Lianglanquan/--2026/机械资料/03_适配模型/04_装配检查/全适配总装_v1_轴测预览.png

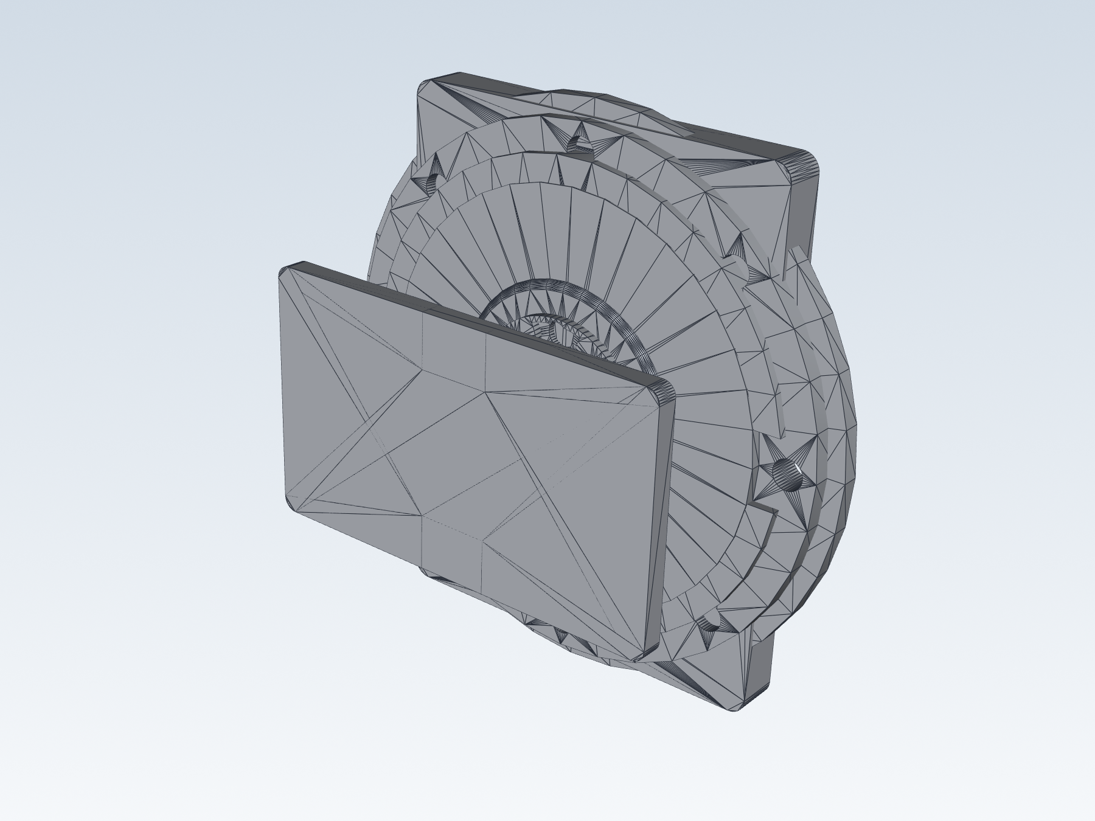
机械资料/03_适配模型/04_装配检查/全适配总装_v1_轴测预览.png
