Lianglanquan/--2026/docs/superpowers/specs/2026-09-16-ha8-qd4310-mechanical-adapter-design.md

# 灯哥轮足机器人 HA8 与 QD4310 机械适配设计

日期：2026-09-16

## 1. 目标

在灯哥 StackForce 小型双足轮足机器人公开机械模型基础上，完成一套可制造、可拆装的接口适配模型，使机器人采用：

- 腿部关节：FashionStar `HA8-U25H-M` 总线舵机 ×4；
- 左右轮驱动：`QD4310` 外转子无刷电机 ×2；
- QD4310 直驱车轮，不增加齿轮、同步带或额外传动级。

设计尽量保持原机器人的腿长、关节中心、轮轴中心、车轮外径、轮宽和总体外观比例。原始 STL 只作为几何参考，绝不覆盖、改写或替换。

## 2. 已确认的设计原则

- 保留原版车轮约 `Ø66 × 30 mm` 的外包络及原轮胎。
- HA8 输出侧使用官方金属 25T 主舵盘；不打印、不重建 25T 花键。
- HA8 背面中心 M3 螺纹孔作为被动支撑轴的连接点，形成双侧支撑。
- QD4310 定子固定在腿部末端，外转子与车轮轮毂连接。
- 优先新增或局部替换接口件，不为了统一外观重做不受影响的结构件。
- 所有原始 CAD、STEP、STP、STL、DWG 和 PDF 保持原样并留在现有资料目录。

## 3. 输入资料与设计基准

### 3.1 原始结构

原始 STL 位于：

`机械资料/01_灯哥小型轮足/01_原版STL/`

现有公开模型共 29 个 STL。设计基准包括原腿长、关节中心、轮轴中心、原车轮外轮廓和原结构件之间的搭接关系。

### 3.2 HA8-U25H-M

官方资料位于：

`机械资料/02_华馨京_HA8-U25H-M/`

设计使用以下已核对特征：

- 舵机本体约 `40 × 20 × 40 mm`；
- 安装耳总高约 `56 mm`；
- 安装孔为 `4 × Ø4.3 mm`；
- 输出轴为约 `Ø5.9 mm / 25T`；
- 背面中心连接为 `M3`；
- 输出侧使用官方 `main-horn-25T-8holes-3D.STEP` 金属舵盘模型作为装配基准。

具体孔距、安装耳位置、输出轴偏置和舵盘孔位以官方 STEP/DWG 为唯一建模依据，不从网页示意图反推。

### 3.3 QD4310

设计使用本地 `QD4310使用手册.pdf` 中的尺寸页作为基准：

- 电机外径 `Ø49 mm`；
- 总厚度 `26.7 mm`；
- 主体厚度标注 `15 mm`；
- 转子侧连接为 `8 × M3 × 0.5`；
- 定子后侧连接为 `4 × M2.5 × 0.45`，孔系 `Ø38.5 mm`。

手册未明确或图纸无法唯一判定的尺寸不得猜测。相关位置保留为可调参数，并在首件装配前用实物复测。

## 4. 修改范围

### 4.1 首版必须输出的适配件

HA8 关节接口：

- `舵机接口1~4` 的 HA8 适配版本；
- 与 HA8 本体和背面被动轴发生干涉的 `外固定1~4` 适配版本；
- 与 HA8 外形、线束或螺钉工具空间发生干涉的 `盖板1~4` 适配版本。

QD4310 轮端接口：

- `电机固定X1/X2` 的 QD4310 定子安装版本；
- `轮固定X1/X2` 的 QD4310 直驱适配版本；
- `轮毂X1/X2` 的 QD4310 外转子连接版本。

左右件应由同一套参数化几何镜像生成，不分别手工绘制两套尺寸。

### 4.2 原则上保持不变的零件

- `大腿1~4`；
- `前小臂X1/X2`；
- `后小臂X1/X2`；
- `框架.stl`；
- `上盖.stl`；
- `电池架.stl`；
- 原轮胎和车轮外轮廓。

只有在装配检查证明存在不可消除的实体干涉、紧固件无法安装或线束无法通过时，才允许将受影响零件加入后续修改范围。不得为了凑齐新模型而重建这些零件。

## 5. HA8 关节结构

### 5.1 输出侧

官方金属 25T 主舵盘安装在 HA8 输出轴上。新增打印适配盘通过官方舵盘的机械孔连接原腿部件，承担扭矩传递。打印件不直接拟合花键，也不依靠摩擦夹紧输出轴。

适配盘必须：

- 保持原关节旋转中心位置；
- 为舵盘中心紧固螺钉和周向螺钉提供装配及工具空间；
- 使用沉孔、柱形沉台或螺母槽时保证周围最小壁厚；
- 使舵盘金属面可靠贴合，不让打印毛边成为主要定位面。

### 5.2 被动支撑侧

HA8 背面中心 M3 连接被动支撑轴。被动轴与外侧支撑件配合，使关节形成双侧支撑，但不得把轴向预紧力直接施加到舵机壳体导致卡滞。

被动侧采用可拆换轴套/隔套结构，并满足：

- 与输出轴同轴；
- 允许通过垫片调整轴向间隙；
- 不把普通打印孔作为高负载旋转轴承面；
- 优先容纳金属隔套、法兰轴承或耐磨衬套，最终规格由实物空间复核后确定。

### 5.3 舵机本体固定与线束

HA8 使用安装耳固定，本体不采用破坏外壳的夹持方式。设计需留出：

- 四个安装孔的螺钉、垫片和螺母空间；
- UART/电源线的自然弯曲半径；
- 插头拔插和舵机独立拆卸路径；
- 至少一个明确的线束出口与防磨边缘。

舵机零位应在参数化装配中显式定义，四个关节使用一致的零位基准和镜像方向说明。

## 6. QD4310 轮端结构

### 6.1 定子固定

电机后侧 `4 × M2.5` 孔固定到腿部末端支架。支架承担定子反扭矩，并保持原轮轴中心。支架必须为电机线束留出不被转子扫过的出口。

### 6.2 转子与轮毂

车轮轮毂通过转子侧 `8 × M3` 孔连接 QD4310 外转子。连接面以电机官方端面和孔系定位，禁止依赖打印件内孔与转子外圆的过盈夹紧承担主要扭矩。

轮毂设计必须：

- 保持约 `Ø66 mm` 原车轮外径与约 `30 mm` 总宽度；
- 使轮胎中心平面尽量与原轮胎中心平面重合；
- 留出 M3 螺钉头、工具和拆装空间；
- 避免固定螺钉突出到轮胎、地面或静止支架的扫掠区；
- 提供可靠的径向定位台阶，螺钉主要承担夹紧和扭矩传递。

### 6.3 轴向空间

QD4310 总厚度 `26.7 mm`，接近原轮约 `29.9 mm` 宽度。首版模型必须通过剖面检查证明电机、支架、轮毂、螺钉和轮胎全部位于允许包络内。若无法同时满足，应优先小幅调整轮毂内腔和支架厚度，不改变原车轮外径；任何轮宽增加都必须单独标注并再次确认。

## 7. 参数化建模与文件组织

新增目录：

```text
机械资料/03_适配模型/
├── 01_参数化源文件/
├── 02_STEP装配与零件/
├── 03_STL打印件/
├── 04_装配检查/
└── 05_设计说明/
```

要求：

- 参数化源文件是适配模型的主数据；
- 每个制造零件同时导出 STEP 和 STL；
- STEP 使用毫米单位，保留实体；
- STL 使用毫米单位，保持封闭、流形和正确法向；
- 文件名包含用途、侧别和版本，不覆盖原始文件；
- 输出目录中附带输入资料、关键尺寸、版本和导出记录；
- 原始 STL 不经布尔运算后覆盖回原目录。

若当前环境选用 CadQuery，则源文件使用可复现的 Python/CadQuery 参数化脚本；若选用 FreeCAD，则保留原生参数化工程。不得只交付无法追溯参数的 STL。

## 8. 制造尺寸规则

首版按常见 FDM 打印和金属紧固件装配设计，采用以下默认规则：

- 普通穿孔相对公称螺钉直径增加 `0.2~0.4 mm`；
- 打印件活动配合单边间隙初值 `0.20 mm`；
- 非活动插接定位单边间隙初值 `0.10~0.15 mm`；
- 承力外壁和螺钉柱有效壁厚原则上不小于 `3.0 mm`；
- 热熔铜螺母、压入螺母和轴承配合不使用通用经验值直接定稿，必须按实际采购件尺寸建模；
- M2.5 与 M3 螺纹由金属件承担；打印件默认使用穿孔、螺母或铜螺母，不直接打印承力细牙螺纹。

所有默认间隙均作为参数保存。首件打印后可按实际打印机、材料和安装件实测统一调整。

## 9. 装配与验证

### 9.1 数字检查

- 原关节中心和轮轴中心相对基准的偏差不超过 `0.20 mm`；
- 左右镜像件的非镜像尺寸完全一致；
- HA8 全关节预期转角内无本体、安装耳、线束和腿部件碰撞；
- QD4310 转子、轮毂和轮胎扫掠体不碰静止支架或线束；
- 所有螺钉均存在可执行的装入方向与工具空间；
- 每个电机和舵机可单独拆卸，不需要破坏打印件；
- 所有 STL 均为非空、封闭流形，并记录三角面数量和包围盒；
- STEP 与 STL 的包围盒一致，单位无 25.4 倍或 1000 倍错误。

### 9.2 实物首件检查

在最终承力打印前，先制作低成本接口样件验证：

- HA8 安装耳孔位、输出侧舵盘孔位和背面 M3 同轴性；
- QD4310 前后孔系、端面位置和线束出口；
- 原轮胎与新轮毂配合；
- 关节零位、可用转角和拆装顺序。

实测偏差写回参数，不直接在 STL 网格上修补。

## 10. 输出清单

首版至少交付：

- HA8 输出侧适配盘 `1~4` 四个编号变体，由同一套参数和镜像规则生成；
- HA8 被动支撑件及所需隔套；
- HA8 本体安装/外固定适配件；
- 受干涉影响的盖板适配件；
- QD4310 左右定子支架；
- QD4310 左右直驱轮毂/轮固定结构；
- 参数化源文件；
- 对应 STEP、STL；
- 总装或分总成 STEP；
- 爆炸图、剖面图或装配截图；
- 零件与紧固件 BOM；
- 尺寸来源、假设、实物待复测项和版本记录。

## 11. 明确不在本轮范围内

- 修改电控、固件、总线协议或控制算法；
- 改变腿长、关节中心、轮轴中心或运动学参数；
- 重新设计整机外壳、框架、电池架或腿部主体；
- 为 HA8 打印 25T 花键；
- 为 QD4310 增加减速器或传动机构；
- 修改或覆盖任何官方/开源原始模型；
- 在未取得实物尺寸时猜测未标注的配合尺寸。

## 12. 完成标准

本轮机械适配完成需同时满足：

1. 四个 HA8 关节保持原旋转中心并具备输出侧金属舵盘连接和背面被动支撑；
2. 两个 QD4310 以定子固定、外转子驱动车轮的方式安装，并保持原轮外径；
3. 原始 STL 全部未被修改；
4. 每个新增制造件都有参数化源、STEP 和 STL；
5. 数字装配检查无实体干涉，紧固件和线束具有可执行的安装路径；
6. 所有无法由官方图纸确认的配合尺寸均被标为实物待复测项，而不是被静默猜测；
7. 输出清单、BOM、校验结果和版本说明完整。
