Lianglanquan/--2026/docs/HA8_遥想星空腿杆接口资料汇总_v1.md

# HA8 总线舵机与遥想星空腿杆接口资料汇总
+
版本：v1
日期：2026-09-24
状态：结构方案评审资料，不是最终加工图
+
## 1. 当前要解决的问题
+
遥想星空 `Skythinker616/foc-wheel-legged-robot` 原结构的关节模块使用 4010 电机。当前目标是用华馨京 / FashionStar `HA8-U25H-M` 总线舵机替换原 4010 关节，并让 HA8 的原厂金属 25T 舵盘与遥想星空腿杆可靠连接。
+
本阶段只处理 HA8 关节接口，不确定 QD4310 轮端执行器，不修改车身、电池架、上盖和轮胎。
+
## 2. 资料来源
+
### 2.1 遥想星空开源项目
+
- GitHub：`https://github.com/Skythinker616/foc-wheel-legged-robot`
- Gitee 入口：项目 README 中的 `skythinker/foc-wheel-legged-robot` 链接
- MATLAB 腿部解算：`matlab/leg_func_calc.m`
- MATLAB 生成函数：`matlab/leg_pos.m`、`matlab/leg_conv.m`
- 平衡控制腿长范围：`matlab/sys_calc.m`
- 机械源文件：`solidworks/大腿.SLDPRT`、`solidworks/小腿.SLDPRT`、`solidworks/关节电机支架.SLDPRT`、`solidworks/总装.SLDASM`
- 本地 STEP 交付包：`/home/fool/Documents/xwechat_files/wxid_4mpuku9s8v2522_6753/msg/file/2026-09/FOC双轮腿机器人_STEP.zip`
- 本地 STEP 目录：`机械资料/05_FreeCAD设计/` 和 `/data/extra/codex-tmp/focstep/`
- URDF/CSV：`机械资料/01_灯哥小型轮足/03_来源说明/SF_bipedalWheel.zip` 中的 `urdf/20250820_1.urdf` 与 `urdf/20250820_1.csv`
+
### 2.2 HA8 官方资料
+
- 舵机型号：`HA8-U25H-M`
- 官方手册：`机械资料/02_华馨京_HA8-U25H-M/02_尺寸图_DWG_PDF/Fashion-Star-HA8-U25H-M.pdf`
- 官方系列尺寸图：`机械资料/02_华馨京_HA8-U25H-M/02_尺寸图_DWG_PDF/ha8-hp8-hx8-series-dimension.pdf`
- 官方本体 STEP：`机械资料/02_华馨京_HA8-U25H-M/01_舵机本体_STEP/ha8-hp8-hx8-series-3D.STEP`
- 官方金属舵盘 STEP：`机械资料/02_华馨京_HA8-U25H-M/03_25T舵盘/main-horn-25T-8holes-3D.STEP`
- 官方金属舵盘尺寸图：`机械资料/02_华馨京_HA8-U25H-M/03_25T舵盘/25T主舵盘外观尺寸图.pdf`
+
### 2.3 项目中已有的参数化参考
+
- HA8 适配源文件：`机械资料/03_适配模型/01_参数化源文件/wheelbot_adapter/`
- HA8 现有输出接口源：`ha8_adapters.py`
- HA8 参数源：`parameters.py`
- 现有 HA8 STEP 输出：`机械资料/03_适配模型/02_STEP装配与零件/HA8_舵机接口1~4_v1.step`
- 现有 HA8 STL 输出：`机械资料/03_适配模型/03_STL打印件/HA8_舵机接口1~4_v1.stl`
- 现有设计说明：`机械资料/03_适配模型/05_设计说明/README_适���模型.md`
- 实物待复测清单：`机械资料/03_适配模型/05_设计说明/实物待复测项.md`
+
现有参数化适配件主要是数字装配参考，不能直接宣称已经和遥想星空腿杆最终孔位完成实体装配验证。
+
## 3. 已锁定的 HA8 数据
+
以下数值有官方手册、官方 STEP 或项目参数化源文件依据，可以作为 FreeCAD 建模基线：
+
| 项目 | 数值 | 数据来源 |
-|-|-|
| 舵机型号 | HA8-U25H-M | 官方手册 |
| 本体包络 | 40 × 20 × 40 mm | 官方手册 / 官方 STEP |
| 安装耳总高 | 56 mm | 官方尺寸图 |
| 安装孔数量和名义孔径 | 4 × Ø4.3 mm | 官方尺寸图 / 官方 STEP 圆柱孔 |
| 输出形式 | Ø5.9 mm / 25T | 官方手册和尺寸图 |
| 背面中心连接 | M3 | 官方尺寸图 |
| 官方金属主舵盘 | 25T、八孔 | 官方舵盘 STEP / 尺寸图 |
| 舵盘周向孔 | 8 × Ø1.8 mm | 官方舵盘 STEP 解析 |
| 舵盘孔节圆 | BCD Ø16 mm | 官方舵盘 STEP 解析 |
| 打印承力外壁初值 | 不小于 3.0 mm | 项目打印规则 |
| 活动配合初值 | 单边 0.20 mm | 项目打印规则 |
| 定位配合初值 | 单边 0.10–0.15 mm | 项目打印规则 |
+
注意：官方舵盘的 25T 花键属于金属采购件。打印件不打印、不重建、也不承担 25T 花键功能。
+
## 4. 遥想星空腿部数据
+
### 4.1 MATLAB 杆长参数
+
`matlab/leg_func_calc.m` 中的腿部杆长为：
+
```matlab
l1 = 0.05;   % 50 mm
l2 = 0.105;  % 105 mm
l3 = l2;     % 105 mm
l4 = l1;     % 50 mm
l5 = 0.06;   % 60 mm
```
+
对应关系：
+
- `l1 = l4 = 50 mm`：两侧短连杆 / 电机侧几何杆长；
- `l2 = l3 = 105 mm`：两根长腿杆几何杆长；
- `l5 = 60 mm`：基座两侧连接点的几何间距参数；
- `L0` 虚拟腿长控制拟合范围：`40–140 mm`；
- `L0 = 70 mm` 是常用标称腿长参考值。
+
这些是运动学模型参数，不等于每个打印件的外轮廓尺寸。腿杆端部法兰需要继续从原始 SolidWorks / STEP 总装测量。
+
### 4.2 URDF 关节基准
+
本地 URDF/CSV 给出的关节轴主要沿 Y 轴。轮轴相对小腿关节的局部平移约为 100 mm，当前记录值约 `99.98 mm`。该值是 URDF 原点链推导的参考，整机绝对装配位置仍需总装 STEP 复核。
+
## 5. 本次确定的 HA8 到腿杆连接方案
+
### 5.1 两套接口必须分开
+
1. **HA8 本体固定接口**
   - HA8 两侧安装耳插入或贴合 3D 打印外固定支架。
   - 外固定支架通过 `4 × Ø4.3 mm` 安装耳孔用螺钉固定 HA8 本体。
   - 这套接口只负责把舵机壳体固定到腿部/车身支撑结构，不能承担腿杆输出连接。
+
2. **HA8 输出接口**
   - HA8 顶部安装原厂金属 25T 八孔主舵盘。
   - 遥想星空腿杆关节端不再沿用原 4010 电机输出端，而是重新设计为带法兰的腿杆端部。
   - 腿杆法兰的八个通孔按官方金属舵盘的八孔位置布置，与舵盘同轴。
   - 螺钉穿过金属舵盘周向孔，把金属舵盘和腿杆端部法兰锁紧。
   - 扭矩传递路径为：HA8 25T 花键 → 金属舵盘 → 周向螺钉/法兰贴合面 → 遥想星空腿杆。
   - 腿杆不能直接锁在 HA8 塑料/铝合金壳体上，不能把一个普通圆柱体当成输出接口。
+
### 5.2 腿杆端部法兰应该画成什么
+
工程图应至少包含：
+
- 遥想星空大腿或小腿杆本体的关节端截面；
- 与官方金属舵盘贴合的法兰面；
- 八个与舵盘同轴的通孔；
- 中央输出轴 / 中心螺钉工具避让孔；
- 法兰外缘的承力壁和圆角；
- 螺钉头或螺母的装配方向；
- HA8 输出轴中心、腿杆关节中心和法兰中心的同轴关系；
- 侧视剖面，明确金属舵盘、法兰、腿杆本体的层叠关系。
+
本阶段不应画出未经确认的螺钉长度、螺纹有效深度、腿杆最终孔距或盲孔深度。它们应在图中标为“��实测 / 待与总装 STEP 复核”。
+
### 5.3 背面被动支撑
+
- HA8 背面中心 M3 只用于连接被动支撑轴或支撑座。
- 被动侧应使用金属隔套、法兰轴承或耐磨衬套。
- 普通打印孔不能直接作为高负载旋转轴承面。
- 需要留出垫片或隔套调整轴向间隙，不能用 HA8 壳体承受轴向预紧。
+
## 6. 仍然不能直接锁死的尺寸
+
这些项目必须用官方 STEP、原始总装或实物确认，不能从网页示意图猜测：
+
- HA8 两侧安装耳孔的精确中心距和相对输出轴偏置；
- HA8 输出轴中心到安装基准面的精确距离；
- 官方金属舵盘的实际螺钉规格、有效螺纹深度和装配工具空间；
- 遥想星空原始腿杆关节端最终孔位、端面厚度和法兰外轮廓；
- 输出转接法兰的孔径补偿和沉孔/螺母槽形式；
- 背面被动支撑轴、轴承或衬套型号、外径、长度和轴向间隙；
- HA8 线束出口方向、插头尺寸和最小弯曲半径；
- 原始整机绝对装配坐标和四个关节与车身的最终安装关系。
+
## 7. 本阶段 FreeCAD 建模顺序
+
1. 导入官方 HA8 本体 STEP。
2. 导入官方 25T 八孔金属舵盘 STEP。
3. 导入遥想星空原始大腿 / 小腿端部 STEP 或根据总装截面建立腿杆端面参考。
4. 以 HA8 输出轴为关节基准轴，将金属舵盘与腿杆端部法兰同轴叠合。
5. 在腿杆端部建立八孔通孔和中央工具避让孔。
6. 再建立 HA8 两侧耳外固定支架和背面被动支撑。
7. 先检查螺钉装入方向、法兰贴合、线束空间和关节扫掠，再复制到镜像腿。
8. 通过 FreeCAD 截面和干涉检查后，才导出 STEP/STL。
+
## 8. 当前已有图纸与生成图
+
- 遥想星空原始腿部参数基线：`机械资料/05_参数图/遥想星空原始腿部参数基线_v1.png`
- 第一版 HA8 接口概念图：`机械资料/05_参数图/HA8总线舵机关节接口设计图_v1.png`
- 本次修正版目标图：`机械资料/05_参数图/HA8腿杆端部法兰与金属舵盘接口工程图_v2.png`
+
第一版图的问题是只表达了 HA8 模块关系，没有把腿杆端部按官方金属舵盘孔系重新设计并画出。修正版应以厂家机械图样式表达腿杆法兰和舵盘锁紧关系。
+
## 9. 结论
+
这次的设计重点不是再增加一个孤立转接盘，而是修改遥想星空腿杆关节端：让腿杆端部本身带有与官方金属舵盘相匹配的法兰和八孔接口。HA8 本体由侧耳支架固定，腿杆通过金属舵盘与端部法兰传递扭矩，背面再用 M3 被动支撑保持同轴。
+
在腿杆最终孔位、HA8 精确基准距离、螺钉规格和被动支撑件确认前，这份资料和生成图只能作为 FreeCAD 结构评审基线，不能直接作为最终加工图或直接打印承力件。
