Lianglanquan/--2026/firmware/esp32_s3/UPSTREAM.md

# Upstream provenance

- Project: https://github.com/78/xiaozhi-esp32
- Commit: `5d54beb743ff49c4e8db81bbef9413bdd6e2ba17`
- Imported: 2026-09-16
- License: MIT; see `LICENSE`
- Local additions: `wheelbot-s3-audio` board and `local_components/wheelbot_control`
