Lianglanquan/--2026/docs/superpowers/plans/2026-09-13-机械原始资料下载.md

# 轮足机器人机械原始资料下载实施计划

> **For agentic workers:** REQUIRED SUB-SKILL: Use superpowers:subagent-driven-development (recommended) or superpowers:executing-plans to implement this plan task-by-task. Steps use checkbox (`- [ ]`) syntax for tracking.

**Goal:** 从公开官方/开源来源下载 StackForce 灯哥小型轮足机器人和 FashionStar HA8-U25H-M 相关机械资料，按中文目录保存原始文件，生成来源说明、校验结果和最终 ZIP。

**Architecture:** 先以 Git 仓库和官方直链为主获取原始文件，所有来源先进入临时下载区并记录 URL、版本/提交和 SHA256，再复制到最终中文目录。对 FashionStar 资料按“明确 HA8-U25H-M”“同尺寸系列参考”“未找到”三类归档，禁止转换、重建、覆盖同名文件。

**Tech Stack:** `git`, `curl`/`wget`, `unzip`, `find`, `sha256sum`, `zip`, Markdown。

**Spec:** 用户在当前对话中提供的“轮足机器人机械公开资料下载、整理、校验和打包”要求。

## Global Constraints

- 只使用公开官方或开源资源。
- 不生成、转换、重建或修改任何 STL、STEP、STP、DWG、PDF、URDF、mesh、配置文件。
- 保留原始文件名和原始内容；同名文件不静默覆盖。
- StackForce 原始 STL 与 Seeed 官方 URDF/STL 包分开保存。
- HA8-U25H-M 必须与 HA8-U25-M 7.4V 区分。
- QD4310、HA8 适配属于后续工作，本次不修改任何 CAD。
- 下载日期统一记录为 2026-09-13（Asia/Shanghai）。

---

### Task 1: 核对并获取 StackForce 官方资源

**Files:**
- Create: `机械资料/临时下载/StackForce-GitHub/`
- Create: `机械资料/临时下载/StackForce-Gitee/`
- Create: `机械资料/临时下载/SF_bipedalWheel.zip`

- [ ] 克隆 GitHub 仓库并记录提交哈希。
- [ ] 检查 Gitee 官方镜像并在 GitHub 失败或内容不一致时比较模型目录。
- [ ] 下载 Seeed 官方 ZIP，记录 HTTP URL、文件大小和 SHA256。
- [ ] 枚举仓库模型目录全部 STL，核对用户列出的打印件清单。

### Task 2: 整理 StackForce 目录

**Files:**
- Create: `机械资料/01_灯哥小型轮足/01_原版STL/`
- Create: `机械资料/01_灯哥小型轮足/02_Seeed官方URDF_STL/`
- Create: `机械资料/01_灯哥小型轮足/03_来源说明/`

- [ ] 原样复制仓库模型目录内全部 STL 到 `01_原版STL/`。
- [ ] 原样解压 Seeed ZIP 全部 URDF、STL、mesh、配置文件到 `02_Seeed官方URDF_STL/`。
- [ ] 对同名文件执行显式冲突检查，不覆盖已有文件。
- [ ] 写入 StackForce 来源说明和文件清单。

### Task 3: 核对并获取 FashionStar HA8 资料

**Files:**
- Create: `机械资料/临时下载/servo-dimension/`
- Create: `机械资料/临时下载/FashionStar官方页面快照/`

- [ ] 获取产品页、官方技术文档/CAD 页面和 `servodevelop/servo-dimension` 的公开文件列表。
- [ ] 只将产品型号明确为 `HA8-U25H-M` 的文件归入确定资料。
- [ ] 将可证明为 40×20×40 mm、单轴、25T 但无法证明具体为 HA8-U25H-M 的原始文件归入“同尺寸系列参考”。
- [ ] 未找到的 STEP/STP、DWG、PDF、舵盘或支架明确记录“官方公开资源中未找到”。

### Task 4: 整理 FashionStar 目录和总 README

**Files:**
- Create: `机械资料/02_华馨京_HA8-U25H-M/01_舵机本体_STEP/`
- Create: `机械资料/02_华馨京_HA8-U25H-M/02_尺寸图_DWG_PDF/`
- Create: `机械资料/02_华馨京_HA8-U25H-M/03_25T舵盘/`
- Create: `机械资料/02_华馨京_HA8-U25H-M/04_舵机支架/`
- Create: `机械资料/02_华馨京_HA8-U25H-M/05_来源说明/`
- Create: `机械资料/README_机械资料说明.md`

- [ ] 保留原始文件名并按确定性归档，不改写 CAD 文件。
- [ ] README 记录来源 URL、Git 地址、下载日期、格式、官方性、HA8 确定性、同尺寸参考和后续适配清单。
- [ ] 记录灯哥原始结构与 HA8 官方模型的边界。

### Task 5: 全量校验和打包

**Files:**
- Create: `轮足机器人_机械原始资料_灯哥+HA8.zip`
- Create: `机械资料/05_校验/文件清单.tsv`
- Create: `机械资料/05_校验/SHA256SUMS.txt`

- [ ] 输出完整文件树。
- [ ] 统计 STL、STEP/STP、DWG、PDF、URDF 数量。
- [ ] 检查空文件和 ZIP 解压完整性。
- [ ] 对重要文件计算 SHA256。
- [ ] 检查 ZIP 内部全部使用中文目录。
- [ ] 重新读取校验结果后再报告完成状态和缺失项。
