Lianglanquan/--2026/机械资料/03_适配模型/05_设计说明/实物待复测项.md

# 实物待复测项

当前状态：数字装配版 v1。以下项目未完成前，不得将模型表述为已实体装车验证或直接用于最终承力打印。

## HA8-U25H-M

1. 安装耳实际厚度、四个 Ø4.3 孔的孔径公差和中心距。用游标卡尺及针规测量，并与官方 STEP 叠合检查。
2. 官方金属 25T 八孔主舵盘的实际孔径、孔距、厚度和中心螺钉工具空间。
3. 背面 M3 孔的有效螺纹深度、端面到壳体的轴向距离和允许预紧力。
4. 被动侧金属隔套、法兰轴承或耐磨衬套的采购型号、外径、长度和配合公差。当前 `passive_insert_outer_diameter_mm` 与 `passive_insert_length_mm` 保持未解析。
5. UART/电源插头尺寸、出线位置和最小自然弯曲半径。

## QD4310

1. 转子侧 8×M3 孔的节圆直径（BCD）、角度起点、有效螺纹深度和端面定位尺寸。官方公开手册没有唯一给出 BCD，这是当前最关键的未解析项。
2. 定子侧 4×M2.5、Ø38.5 BCD 的实物孔位和螺纹深度。
3. 前后端面位置、转子与定子的实际分界半径、外转子扫掠包络。
4. 三相线束实际出线位置、插头尺寸和与静止支架的距离。

## 原车轮与打印工艺

1. 原轮胎内孔、卡槽、压缩量和中心平面；核对新轮毂与约 Ø66×29.9 mm 外包络。
2. 打印机在目标材料和层高下的 M2.5/M3 孔径补偿、定位台阶补偿和轴承/隔套压入量。
3. 从完整原装配或实物测量四个关节和两个轮轴的绝对装配坐标。孤立 STL 只能保留局部中心，不能唯一恢复整机绝对位置。

复测后只修改 `01_参数化源文件/wheelbot_adapter/parameters.py` 或对应的命名待测参数，再运行 `build_all.py`；不要直接修补导出的 STL。
