Lianglanquan/--2026/tmp/pdfs/HA8_系列尺寸-1.png

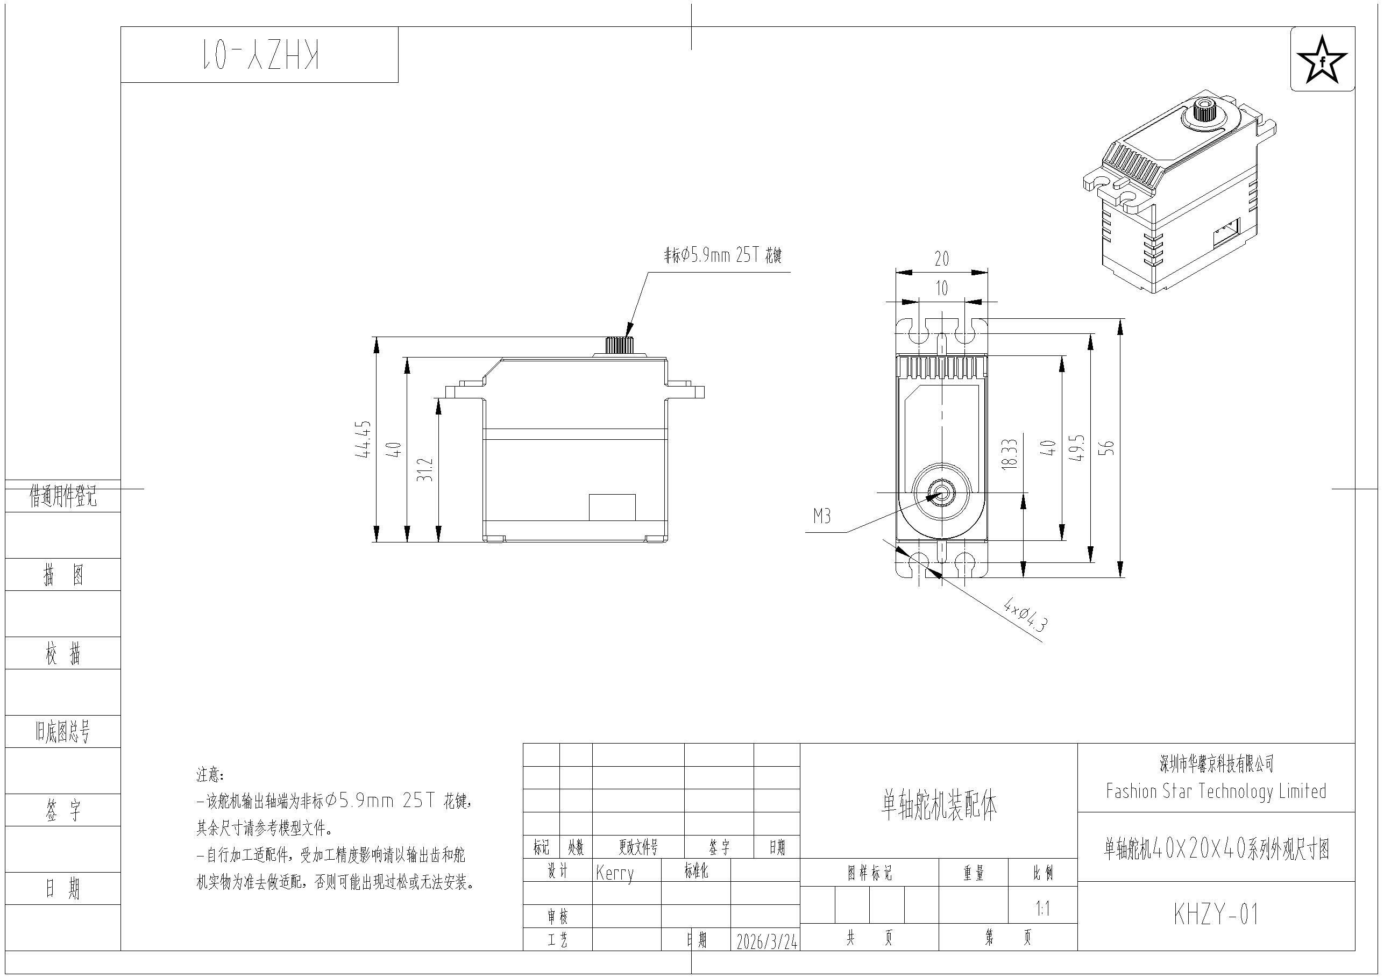
tmp/pdfs/HA8_系列尺寸-1.png
