Lianglanquan/--2026/tmp/pdfs/QD4310_产品尺寸-06.png

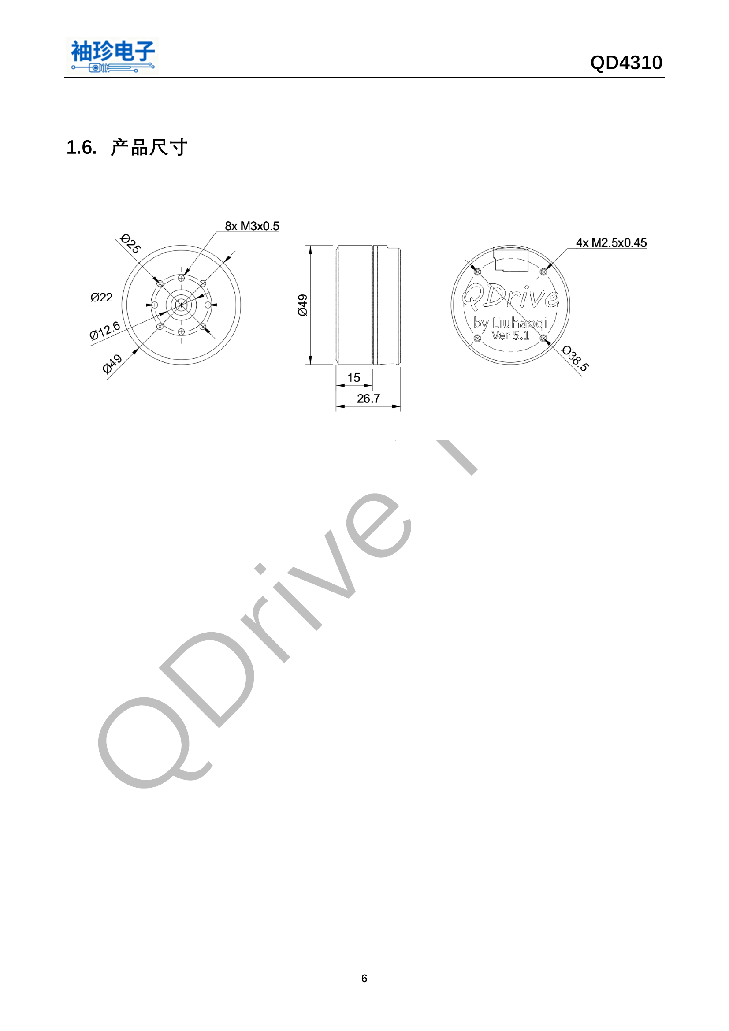
tmp/pdfs/QD4310_产品尺寸-06.png
