Lianglanquan/--2026/机械资料/05_FreeCAD设计/单腿分总成/轮足机器人_左前单腿_v1_front.png

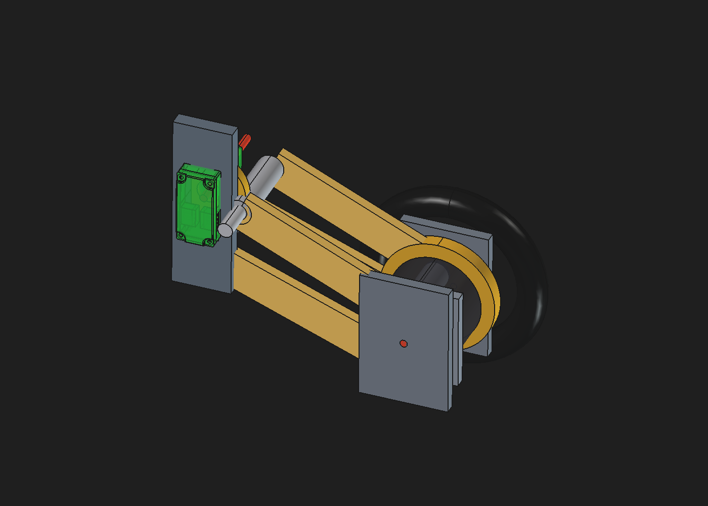
机械资料/05_FreeCAD设计/单腿分总成/轮足机器人_左前单腿_v1_front.png
