Lianglanquan/--2026/机械资料/05_FreeCAD设计/灯哥原始参考/灯哥StackForce原始结构_只读参考.png

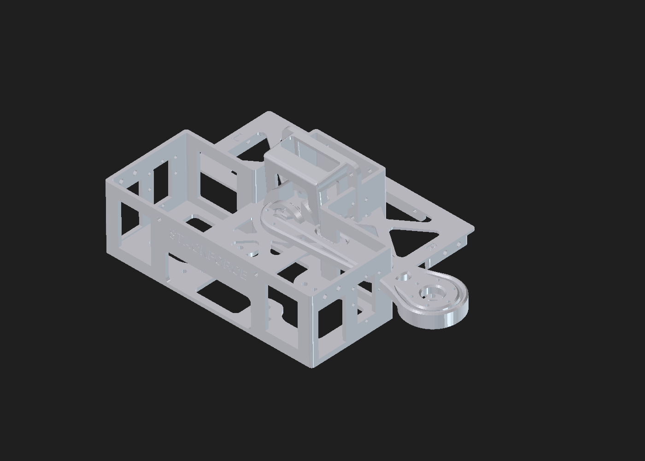
机械资料/05_FreeCAD设计/灯哥原始参考/灯哥StackForce原始结构_只读参考.png
