Lianglanquan/--2026/机械资料/05_FreeCAD设计/灯哥轮腿改造/灯哥轮腿改造_单腿接口对照_v1.png

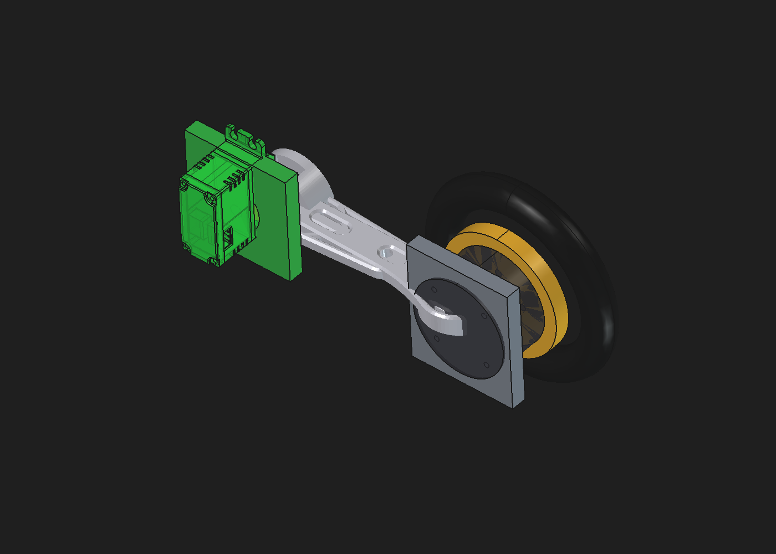
机械资料/05_FreeCAD设计/灯哥轮腿改造/灯哥轮腿改造_单腿接口对照_v1.png
