Lianglanquan/--2026/机械资料/05_FreeCAD设计/轮足机器人_HA8_QD4310_概念总装_v2.png

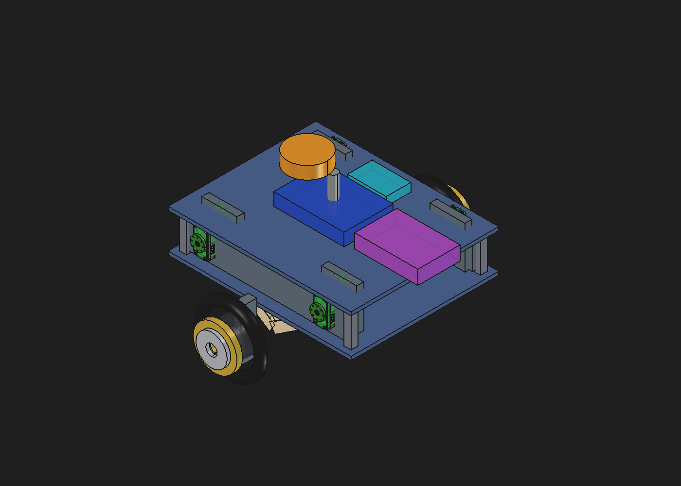
机械资料/05_FreeCAD设计/轮足机器人_HA8_QD4310_概念总装_v2.png
