Lianglanquan/--2026/机械资料/05_参数图/HA8总线舵机关节接口设计图_v1.png

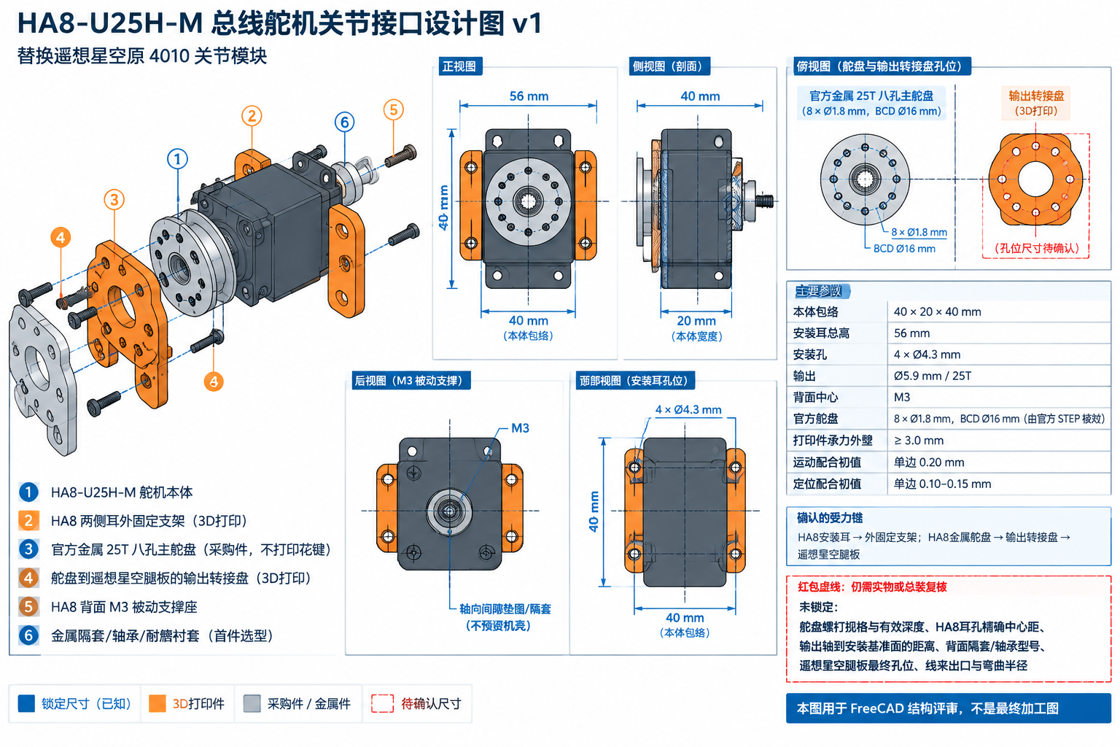
机械资料/05_参数图/HA8总线舵机关节接口设计图_v1.png
