Lianglanquan/--2026/机械资料/05_参数图/HA8腿杆端部法兰与金属舵盘接口工程图_v2.png

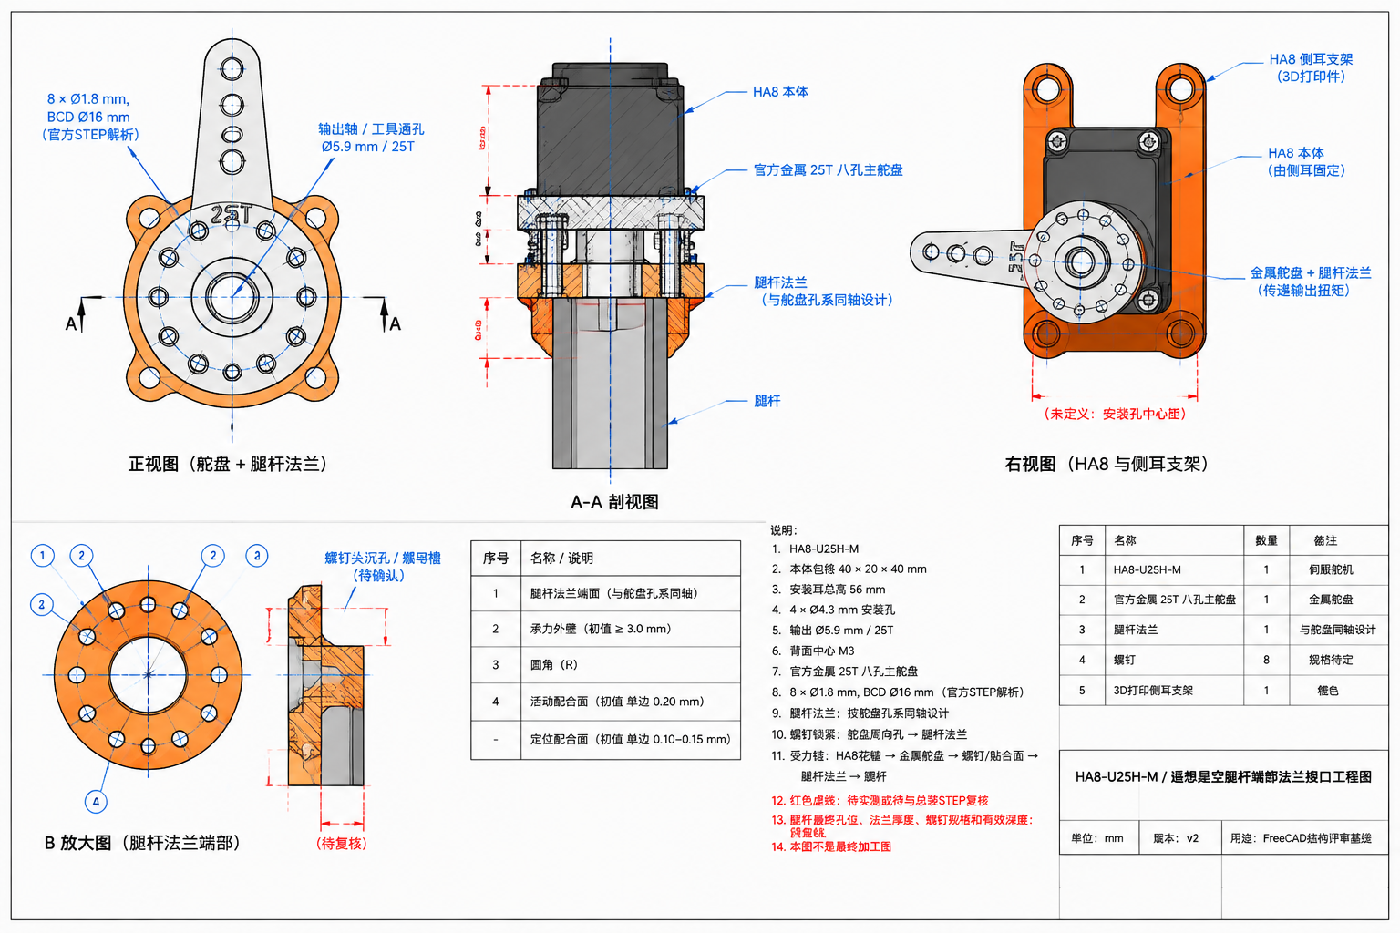
机械资料/05_参数图/HA8腿杆端部法兰与金属舵盘接口工程图_v2.png
