Lianglanquan/--2026/机械资料/05_参数图/遥想星空原始腿部参数基线_v1.png

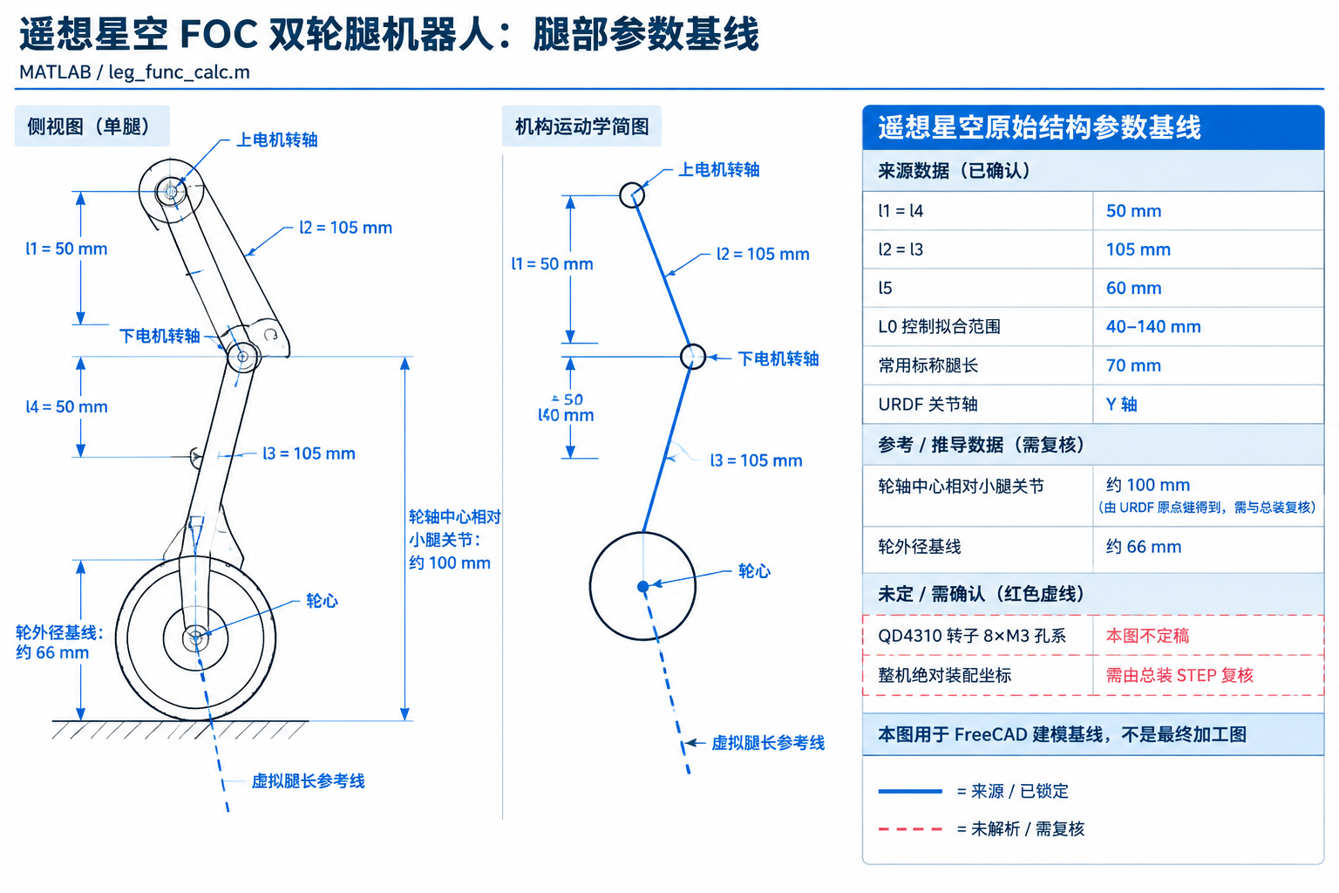
机械资料/05_参数图/遥想星空原始腿部参数基线_v1.png
