Lianglanquan/--2026/全部打印STL/01_灯哥原版_29件/舵机接口3.stl

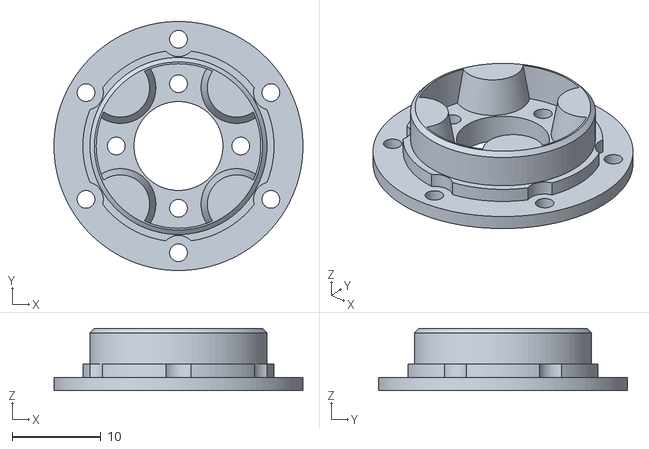
[picture p33: CAD file, 2026-09-26]
全部打印STL/01_灯哥原版_29件/舵机接口3.stl
28.0 x 28.0 x 7.00
