Lianglanquan/--2026/全部打印STL/02_HA8适配_20件/HA8_盖板3_v1.stl

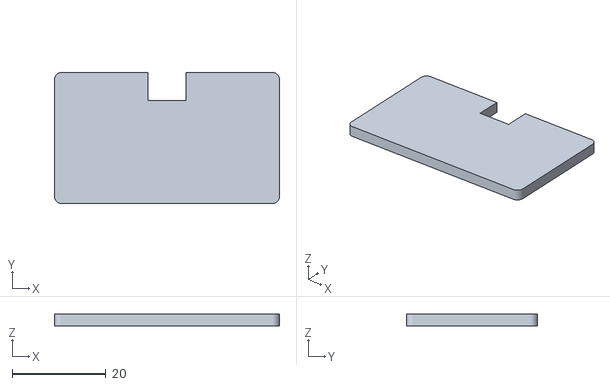
[picture p34: CAD file, 2026-09-26]
全部打印STL/02_HA8适配_20件/HA8_盖板3_v1.stl
48.0 x 28.0 x 2.50
