Lianglanquan/--2026/全部打印STL/03_QD4310适配_6件/QD4310_轮毂X1_v1.stl

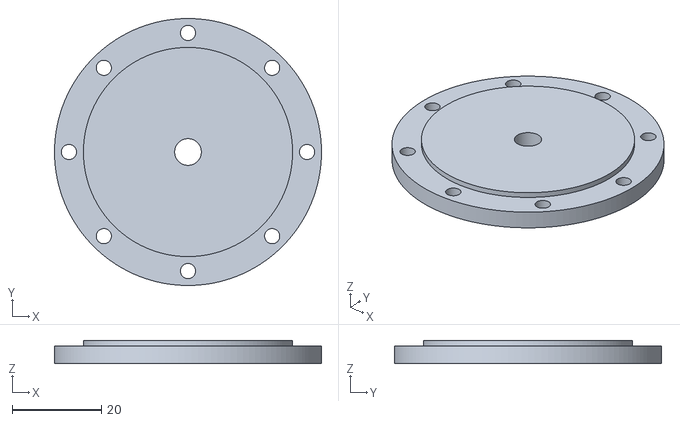
[picture p35: CAD file, 2026-09-26]
全部打印STL/03_QD4310适配_6件/QD4310_轮毂X1_v1.stl
60.0 x 60.0 x 5.20
