Lianglanquan/--2026/全部打印STL/04_顶部俯视摄像头支架_3件/cam_mount_bottom.stl

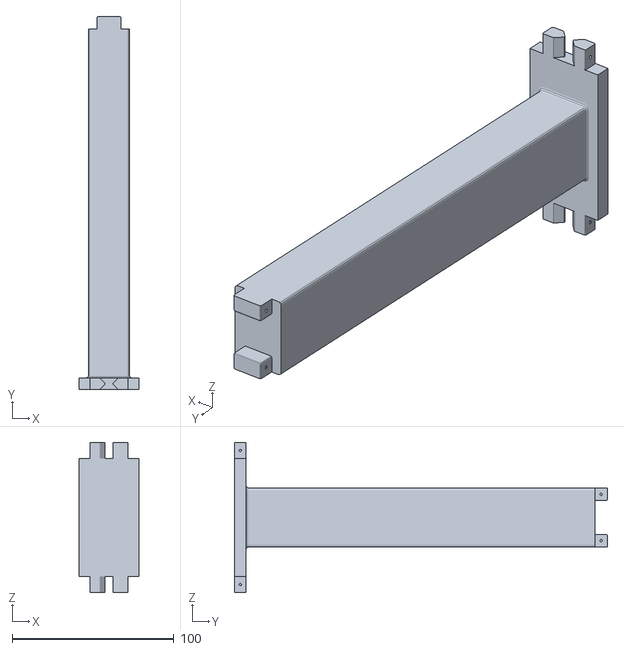
[picture p36: CAD file, 2026-09-26]
全部打印STL/04_顶部俯视摄像头支架_3件/cam_mount_bottom.stl
37.4 x 230.9 x 93.0
