Lianglanquan/--2026/机械资料/03_适配模型/02_STEP装配与零件/HA8_舵机接口1_v1.step

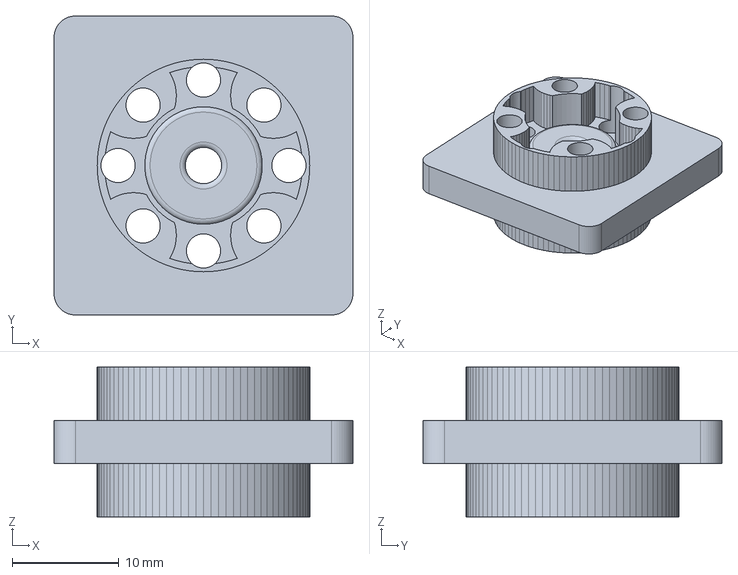
[picture p37: CAD file, 2026-09-26]
机械资料/03_适配模型/02_STEP装配与零件/HA8_舵机接口1_v1.step
28.0 x 28.0 x 14.0 mm
