Lianglanquan/--2026/机械资料/04_顶部俯视摄像头支架_STL/cam_mount_top.stl

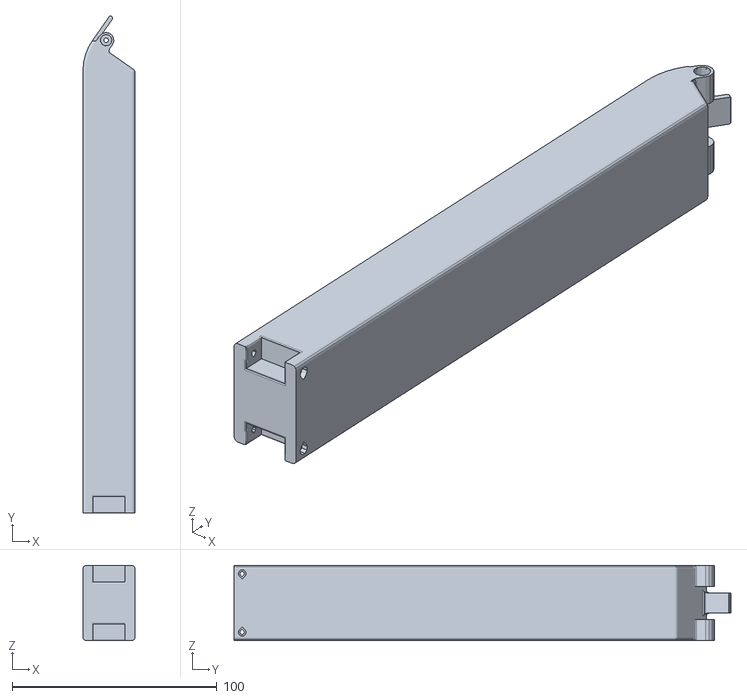
[picture p38: CAD file, 2026-09-26]
机械资料/04_顶部俯视摄像头支架_STL/cam_mount_top.stl
25.4 x 242.5 x 36.6
