Lianglanquan/--2026/机械资料/05_FreeCAD设计/单腿分总成/轮足机器人_左前单腿机械分总成_v1.FCStd

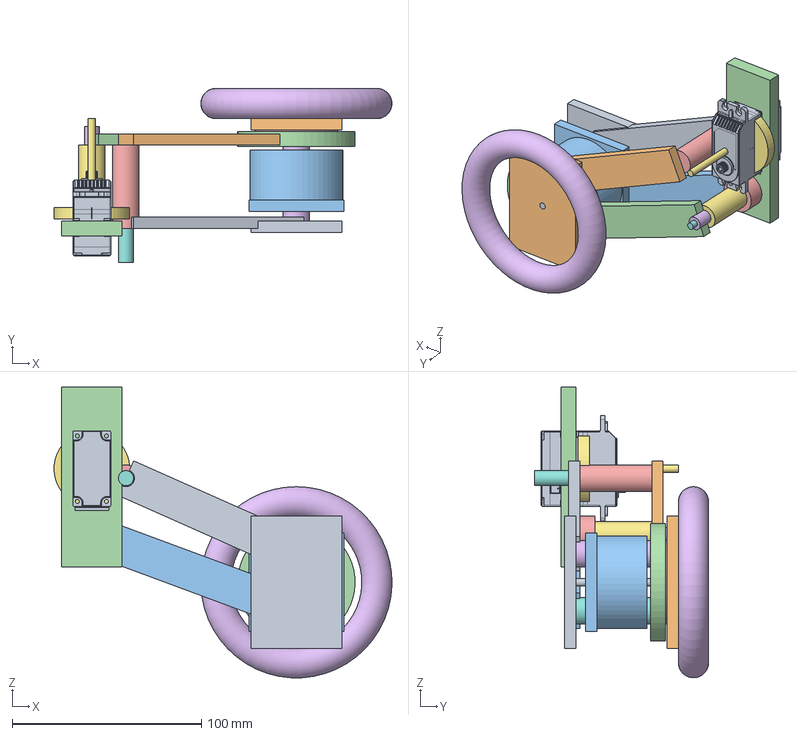
[picture p39: CAD file, 2026-09-26]
机械资料/05_FreeCAD设计/单腿分总成/轮足机器人_左前单腿机械分总成_v1.FCStd
178.5 x 92.0 x 153.4 mm
HA8-U25H-M官方STEP参考
HA8 25T官方舵盘参考
QD4310有方向本体参考
车身侧安装板（单腿基准）
车身被动转轴座
被动转轴/肩螺钉包络
HA8 25T主动曲柄承力盘
主动连杆销轴
主动连杆_Inboard
主动连杆_Outboard
被动连杆_Inboard
被动连杆_Outboard
连杆隔套_A
连杆隔套_C
连杆隔套_B
连杆隔套_D
轮端支架侧板_Inboard
轮端支架侧板_Outboard
QD4310后侧4×M2.5安装板
QD4310前侧8×M3轮毂过渡盘
可替换轮毂定位/夹紧接口
85 mm橡胶轮胎采购件包络
HA8轴心
被动轴心
QD4310轮轴心
