Lianglanquan/--2026/机械资料/05_FreeCAD设计/灯哥原始参考/灯哥StackForce原始结构_只读参考.FCStd

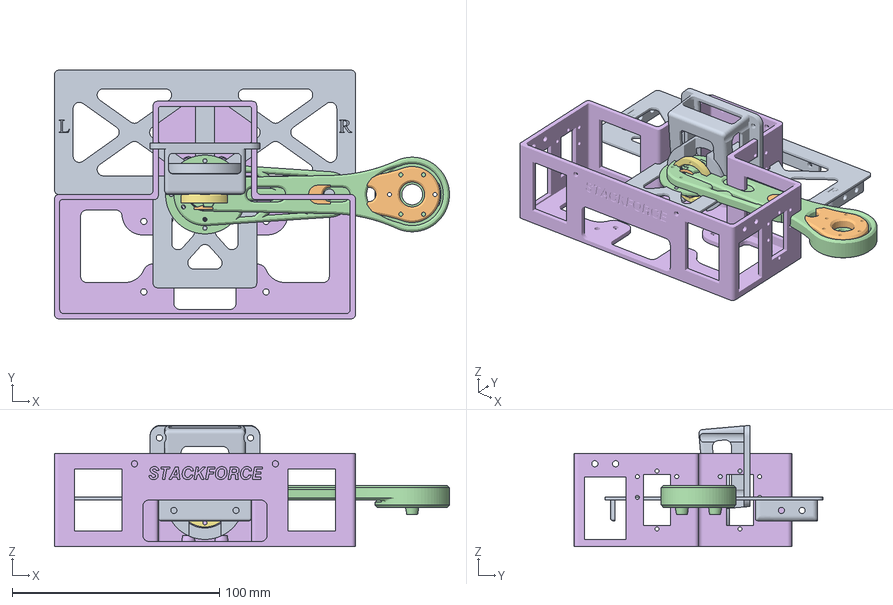
[picture p40: CAD file, 2026-09-26]
机械资料/05_FreeCAD设计/灯哥原始参考/灯哥StackForce原始结构_只读参考.FCStd
190.6 x 120.0 x 58.5 mm
上盖.stl
前小臂X1.stl
前小臂X2.stl
后小臂X1.stl
后小臂X2.stl
外固定1.stl
外固定2.stl
外固定3.stl
外固定4.stl
大腿1.stl
大腿2.stl
大腿3.stl
大腿4.stl
框架.stl
电机固定X1.stl
电机固定X2.stl
电池架.stl
盖板1.stl
盖板2.stl
盖板3.stl
盖板4.stl
舵机接口1.stl
舵机接口2.stl
舵机接口3.stl
舵机接口4.stl
轮固定X1.stl
轮固定X2.stl
轮毂X1.stl
轮毂X2.stl
