Lianglanquan/--2026/机械资料/05_FreeCAD设计/灯哥轮腿改造/灯哥轮腿改造_单腿接口对照_v2.FCStd

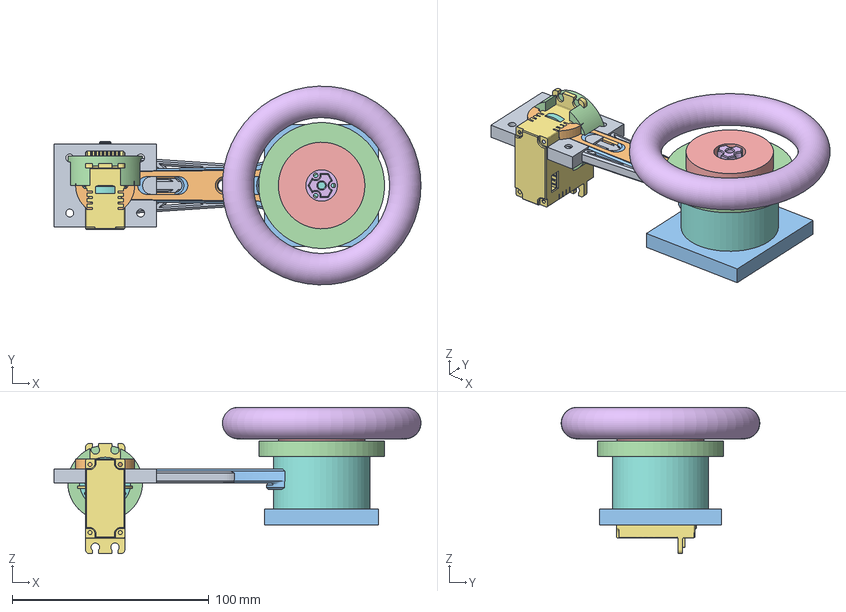
[picture p41: CAD file, 2026-09-26]
机械资料/05_FreeCAD设计/灯哥轮腿改造/灯哥轮腿改造_单腿接口对照_v2.FCStd
186.5 x 101.0 x 74.3 mm
HA8到灯哥大腿转接板（Z轴）
HA8 25T舵盘到灯哥大腿连接盘（Z轴）
QD4310后侧到灯哥轮固定件转接板（Z轴）
QD4310前侧到灯哥轮毂转接盘（Z轴）
轮毂/抱紧联轴器适配段（Z轴）
85mm橡胶轮胎包络（Z轴）
HA8-U25H-M官方参考体（接口轴Z）
QD4310有方向本体参考（Z轴）
复用灯哥_大腿1.stl
复用灯哥_前小臂X1.stl
复用灯哥_后小臂X1.stl
复用灯哥_外固定1.stl
复用灯哥_轮固定X1.stl
复用灯哥_轮毂X1.stl
灯哥旧舵机接口（仅对比）
灯哥旧电机固定件（仅对比）
