Lianglanquan/--2026/机械资料/05_FreeCAD设计/轮足机器人_HA8_QD4310_概念总装_v2.FCStd

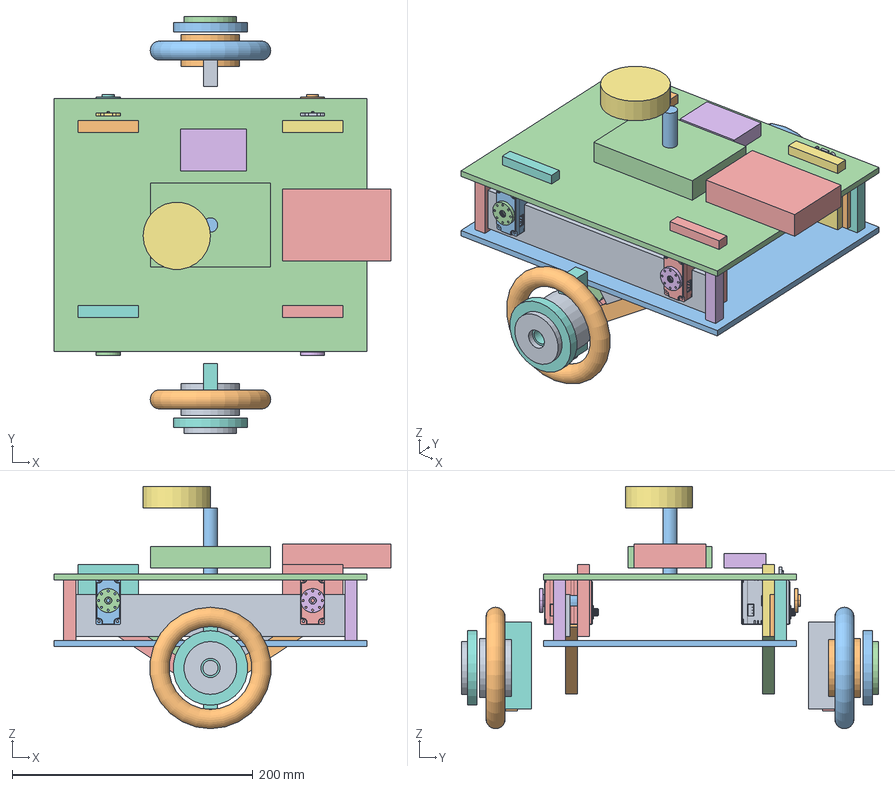
[picture p42: CAD file, 2026-09-26]
机械资料/05_FreeCAD设计/轮足机器人_HA8_QD4310_概念总装_v2.FCStd
280.0 x 346.7 x 201.5 mm
QD4310_L 本体参考（有方向）
QD4310_R 本体参考（有方向）
HA8_LF 官方STEP参考
HA8_LF 25T舵盘官方STEP参考
HA8_LR 官方STEP参考
HA8_LR 25T舵盘官方STEP参考
HA8_RF 官方STEP参考
HA8_RF 25T舵盘官方STEP参考
HA8_RR 官方STEP参考
HA8_RR 25T舵盘官方STEP参考
下层承载板
上层叠加板
叠层立柱1
叠层立柱2
叠层立柱3
叠层立柱4
侧向承载梁
侧向承载梁001
激光雷达立柱
腿连杆V2_LF_0
腿连杆V2_LF_1
腿部转轴座_LF0
腿部转轴座_LF1
HA8安装支架_LF
腿连杆V2_LR_0
腿连杆V2_LR_1
腿部转轴座_LR0
腿部转轴座_LR1
HA8安装支架_LR
腿连杆V2_RF_0
腿连杆V2_RF_1
腿部转轴座_RF0
腿部转轴座_RF1
HA8安装支架_RF
腿连杆V2_RR_0
腿连杆V2_RR_1
腿部转轴座_RR0
腿部转轴座_RR1
HA8安装支架_RR
QD4310_L车架承力臂
QD4310_R车架承力臂
85mm 橡胶轮胎（采购件包络）
85mm 橡胶轮胎（采购件包络）001
大疆 C Board
树莓派
ESP32 控制板
激光雷达占位
QD4310_L 前侧8×M3轮端过渡盘
85mm轮胎轮毂定位/夹紧外圆_L
QD4310_L 后侧4×M2.5车架支架
QD4310_R 前侧8×M3轮端过渡盘
85mm轮胎轮毂定位/夹紧外圆_R
QD4310_R 后侧4×M2.5车架支架
