Lianglanquan/--2026/全部打印STL/01_灯哥原版_29件/轮毂X2.stl

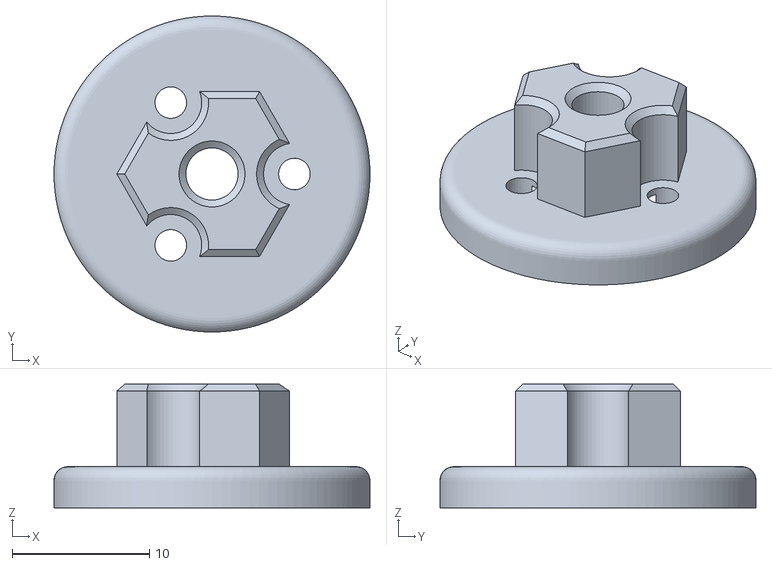
[picture p43: CAD file, 2026-09-26]
全部打印STL/01_灯哥原版_29件/轮毂X2.stl
23.0 x 23.0 x 9.00
