Lianglanquan/--2026/全部打印STL/02_HA8适配_20件/HA8_被动支撑4_v1.stl

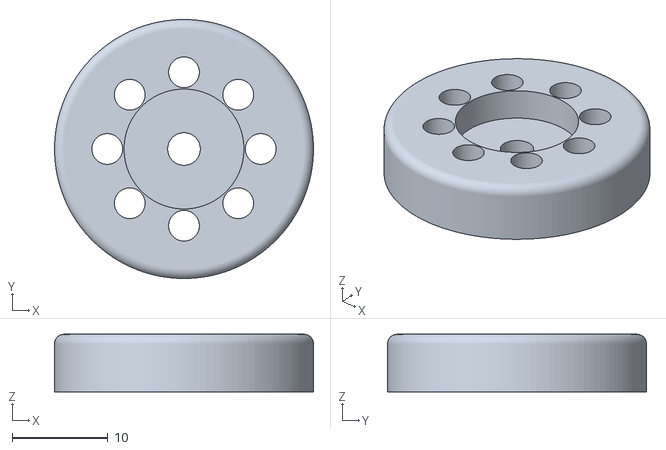
[picture p44: CAD file, 2026-09-26]
全部打印STL/02_HA8适配_20件/HA8_被动支撑4_v1.stl
27.0 x 27.0 x 6.00
