Lianglanquan/--2026/全部打印STL/03_QD4310适配_6件/QD4310_轮固定X1_v1.stl

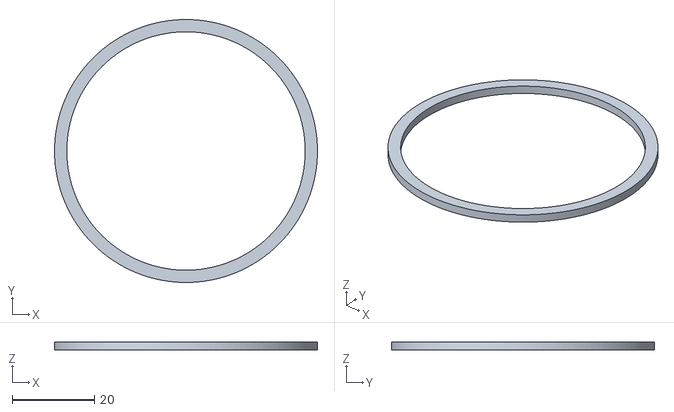
[picture p45: CAD file, 2026-09-26]
全部打印STL/03_QD4310适配_6件/QD4310_轮固定X1_v1.stl
64.0 x 64.0 x 2.00
