Lianglanquan/--2026/全部打印STL/04_顶部俯视摄像头支架_3件/arm_base.stl

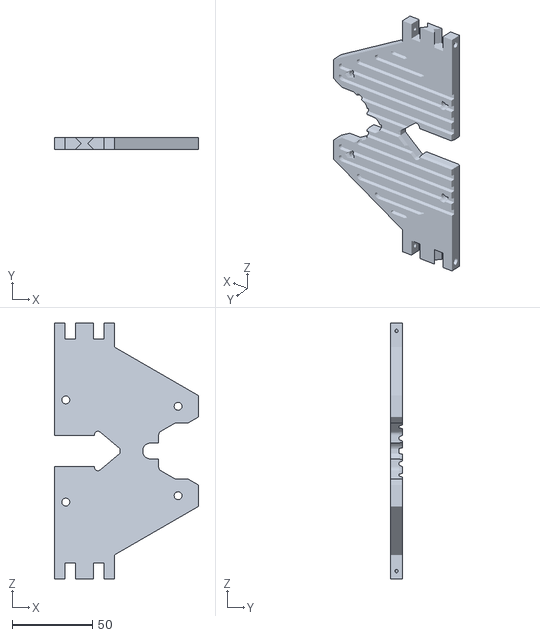
[picture p46: CAD file, 2026-09-26]
全部打印STL/04_顶部俯视摄像头支架_3件/arm_base.stl
89.6 x 7.20 x 159.0
