Lianglanquan/--2026/机械资料/03_适配模型/02_STEP装配与零件/HA8_隔套3_v1.step

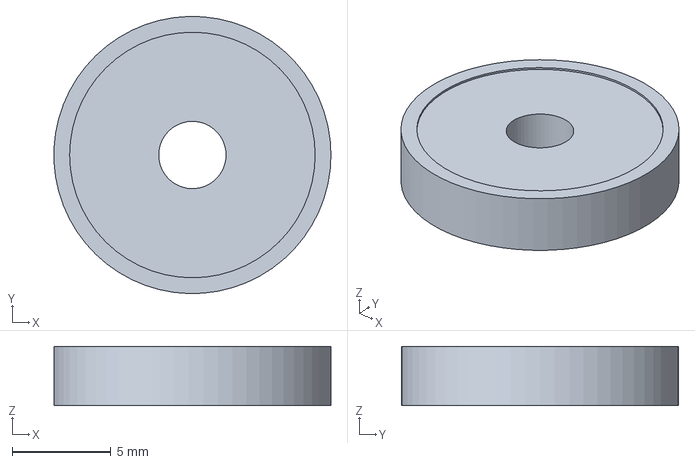
[picture p47: CAD file, 2026-09-26]
机械资料/03_适配模型/02_STEP装配与零件/HA8_隔套3_v1.step
14.0 x 14.0 x 3.00 mm
