Lianglanquan/--2026/全部打印STL/03_QD4310适配_6件/QD4310_电机固定X2_v1.stl

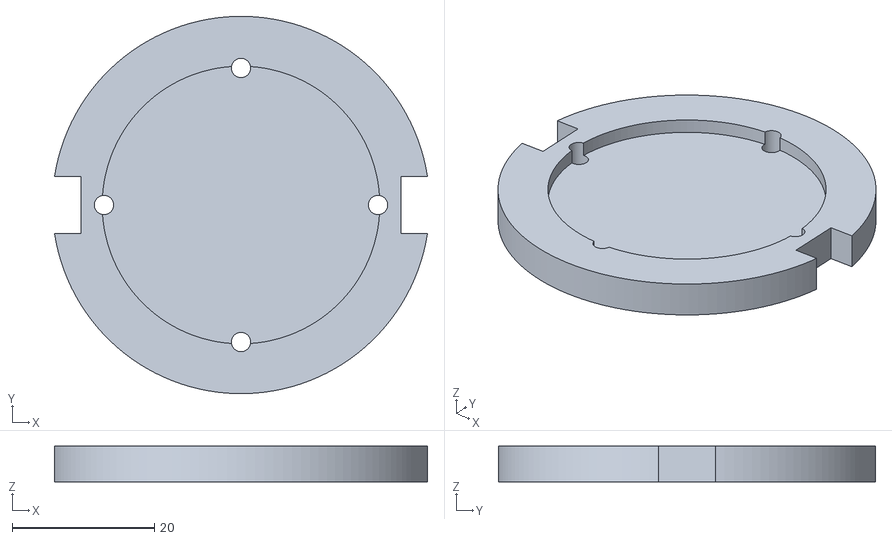
[picture p48: CAD file, 2026-09-26]
全部打印STL/03_QD4310适配_6件/QD4310_电机固定X2_v1.stl
52.4 x 53.0 x 5.00
