Lianglanquan/--2026/机械资料/03_适配模型/02_STEP装配与零件/QD4310_轮端适配分总成_v1.step

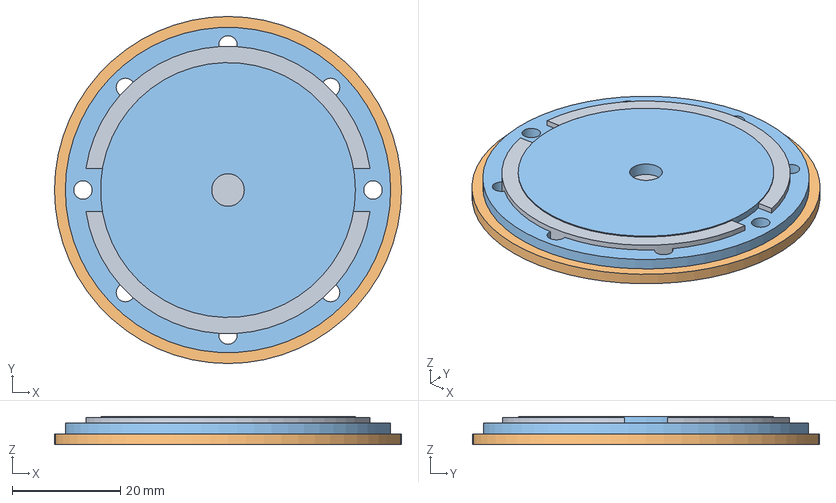
[picture p49: CAD file, 2026-09-26]
机械资料/03_适配模型/02_STEP装配与零件/QD4310_轮端适配分总成_v1.step
64.0 x 64.0 x 5.20 mm
