Lianglanquan/--2026/全部打印STL/01_灯哥原版_29件/轮固定X2.stl

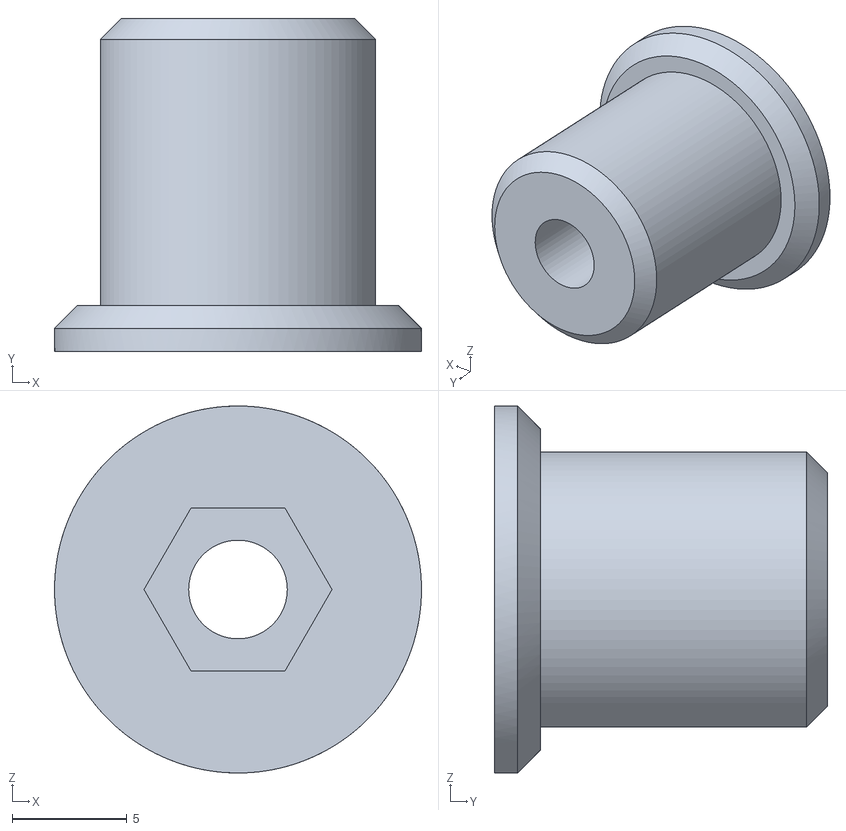
[picture p50: CAD file, 2026-09-26]
全部打印STL/01_灯哥原版_29件/轮固定X2.stl
16.0 x 14.5 x 16.0
