Lianglanquan/--2026/全部打印STL/01_灯哥原版_29件/外固定3.stl

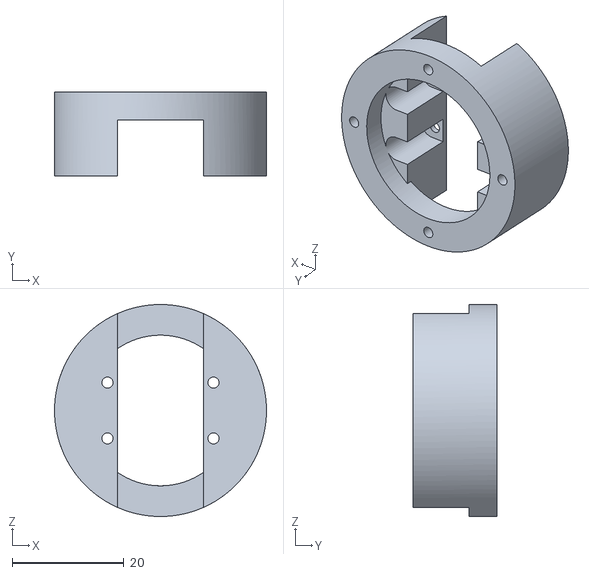
[picture p51: CAD file, 2026-09-26]
全部打印STL/01_灯哥原版_29件/外固定3.stl
38.0 x 15.0 x 38.0
