Lianglanquan/--2026/全部打印STL/01_灯哥原版_29件/大腿1.stl

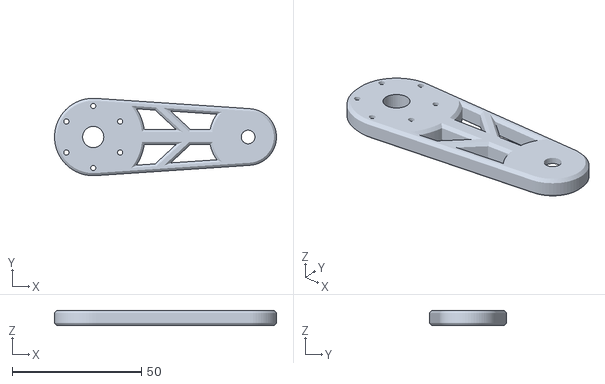
[picture p52: CAD file, 2026-09-26]
全部打印STL/01_灯哥原版_29件/大腿1.stl
86.0 x 30.0 x 6.00
