Lianglanquan/--2026/全部打印STL/02_HA8适配_20件/HA8_外固定2_v1.stl

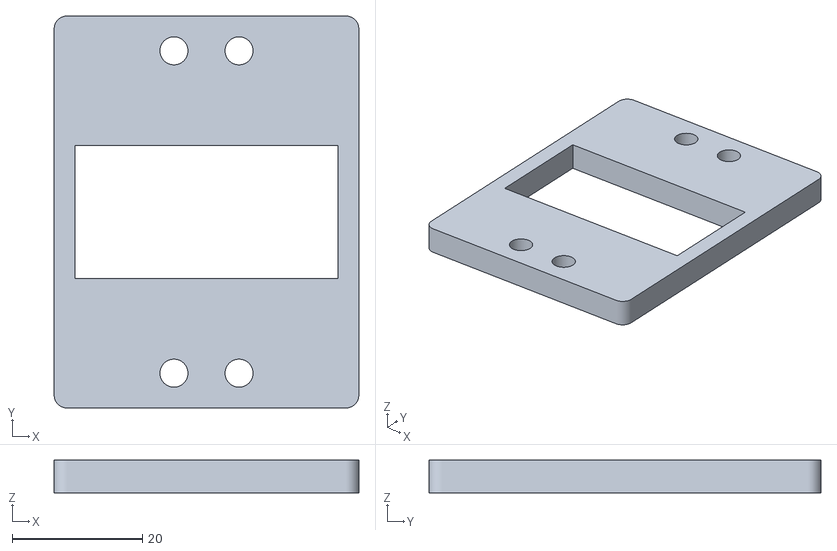
[picture p53: CAD file, 2026-09-26]
全部打印STL/02_HA8适配_20件/HA8_外固定2_v1.stl
46.8 x 60.2 x 5.00
