Lianglanquan/--2026/全部打印STL/01_灯哥原版_29件/盖板1.stl

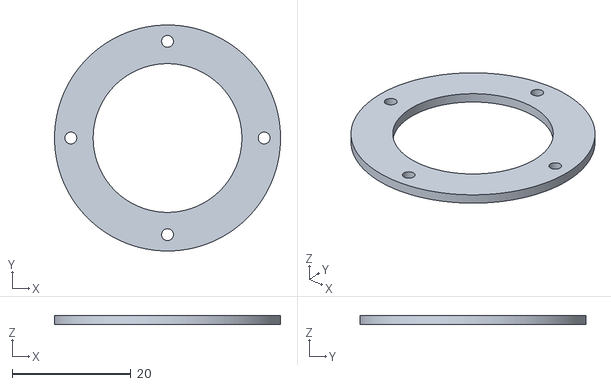
[picture p54: CAD file, 2026-09-26]
全部打印STL/01_灯哥原版_29件/盖板1.stl
38.0 x 38.0 x 1.50
