Lianglanquan/--2026/全部打印STL/01_灯哥原版_29件/前小臂X1.stl

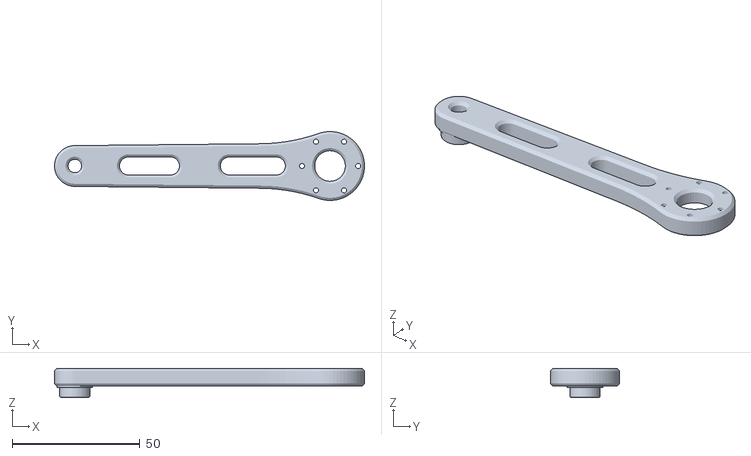
[picture p55: CAD file, 2026-09-26]
全部打印STL/01_灯哥原版_29件/前小臂X1.stl
121.5 x 27.0 x 11.5
