Lianglanquan/--2026/全部打印STL/01_灯哥原版_29件/后小臂X2.stl

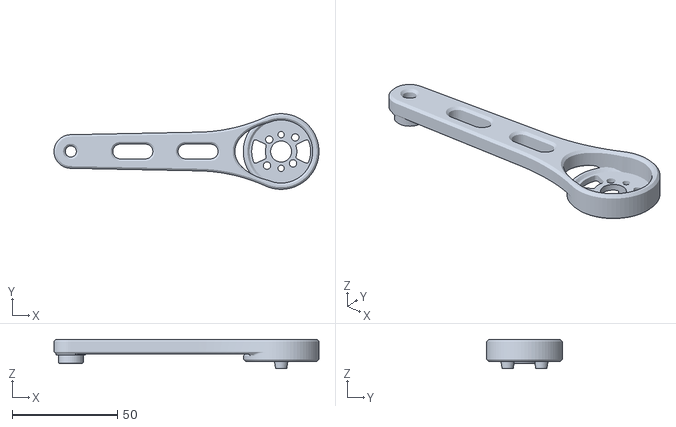
[picture p57: CAD file, 2026-09-26]
全部打印STL/01_灯哥原版_29件/后小臂X2.stl
126.0 x 36.0 x 14.0
