Lianglanquan/--2026/全部打印STL/01_灯哥原版_29件/上盖.stl

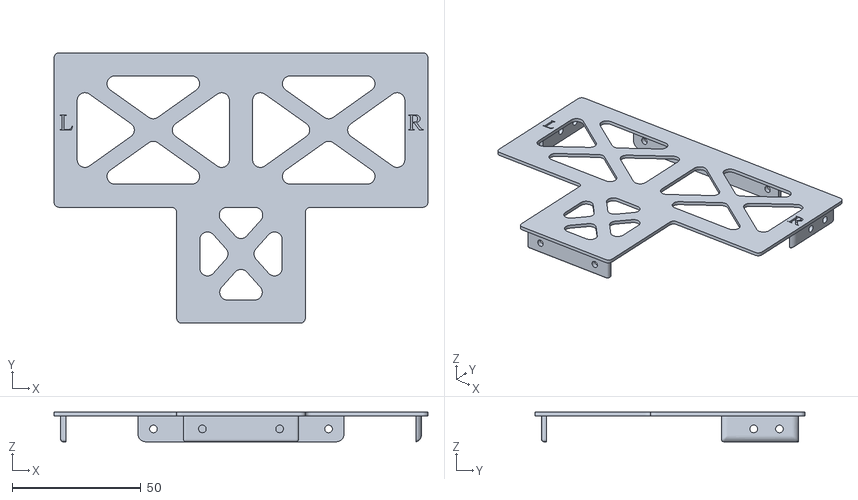
[picture p58: CAD file, 2026-09-26]
全部打印STL/01_灯哥原版_29件/上盖.stl
145.2 x 105.0 x 11.5
