Lianglanquan/--2026/机械资料/03_适配模型/03_STL打印件/HA8_外固定3_v1.3mf

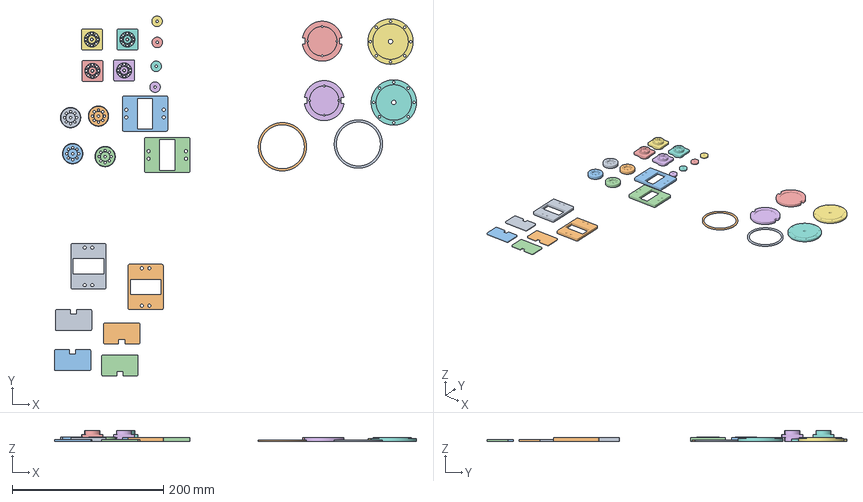
[picture p59: CAD file, 2026-09-26]
机械资料/03_适配模型/03_STL打印件/HA8_外固定3_v1.3mf
478.6 x 475.9 x 14.0 mm
HA8_被动支撑1_v1.stl
HA8_被动支撑2_v1.stl
HA8_被动支撑3_v1.stl
HA8_被动支撑4_v1.stl
HA8_舵机接口1_v1.stl
HA8_舵机接口2_v1.stl
HA8_舵机接口3_v1.stl
HA8_舵机接口4_v1.stl
HA8_盖板1_v1.stl
HA8_盖板2_v1.stl
HA8_盖板3_v1.stl
HA8_盖板4_v1.stl
HA8_隔套1_v1.stl
HA8_隔套2_v1.stl
HA8_隔套3_v1.stl
HA8_隔套4_v1.stl
HA8_外固定1_v1.stl
HA8_外固定2_v1.stl
HA8_外固定3_v1.stl
HA8_外固定4_v1.stl
QD4310_电机固定X1_v1.stl
QD4310_电机固定X2_v1.stl
QD4310_轮毂X1_v1.stl
QD4310_轮毂X2_v1.stl
QD4310_轮固定X1_v1.stl
QD4310_轮固定X2_v1.stl
