Lianglanquan/--2026/全部打印STL/01_灯哥原版_29件/电机固定X1.stl

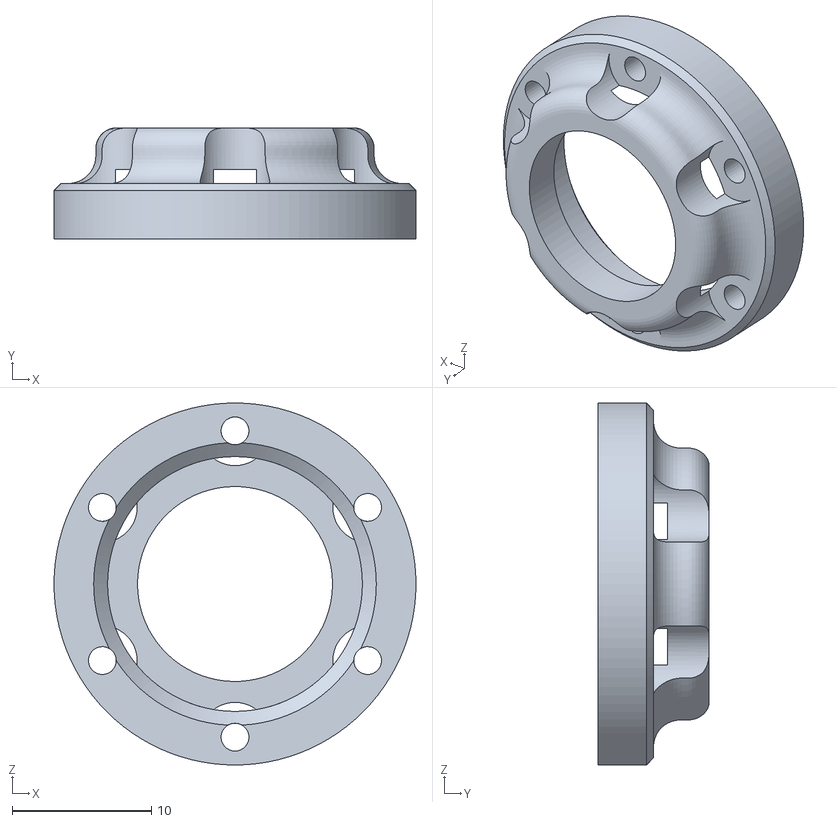
[picture p60: CAD file, 2026-09-26]
全部打印STL/01_灯哥原版_29件/电机固定X1.stl
26.0 x 8.00 x 26.0
