Lianglanquan/--2026/全部打印STL/01_灯哥原版_29件/电池架.stl

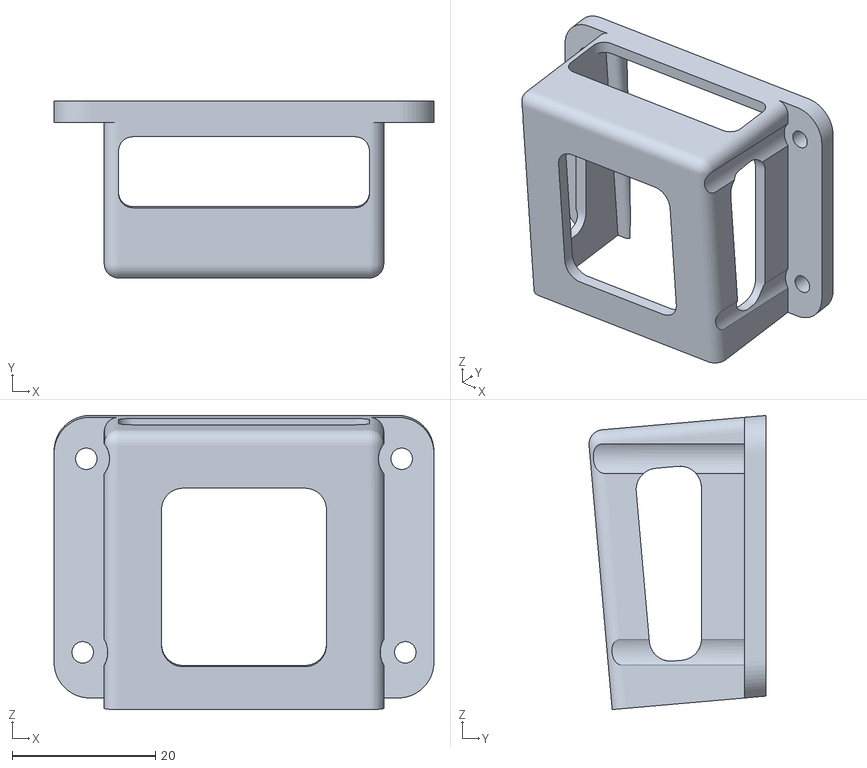
[picture p61: CAD file, 2026-09-26]
全部打印STL/01_灯哥原版_29件/电池架.stl
53.0 x 24.7 x 41.0
