Lianglanquan/--2026/机械资料/03_适配模型/02_STEP装配与零件/HA8_关节适配分总成_v1.step

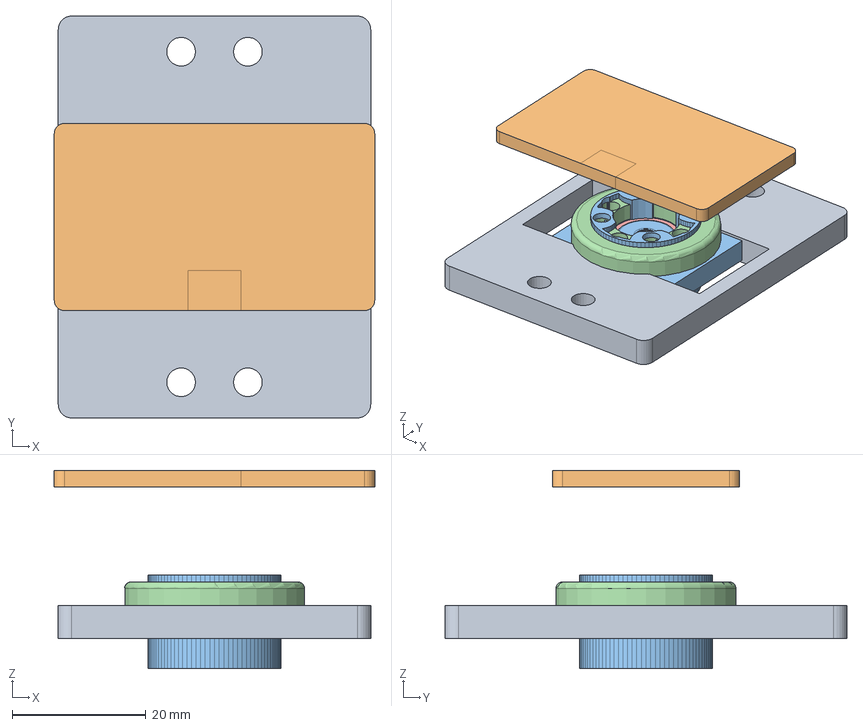
[picture p62: CAD file, 2026-09-26]
机械资料/03_适配模型/02_STEP装配与零件/HA8_关节适配分总成_v1.step
48.0 x 60.2 x 29.7 mm
