Lianglanquan/--2026/机械资料/03_适配模型/02_STEP装配与零件/轮足机器人_HA8_QD4310_全适配总装_v1.step

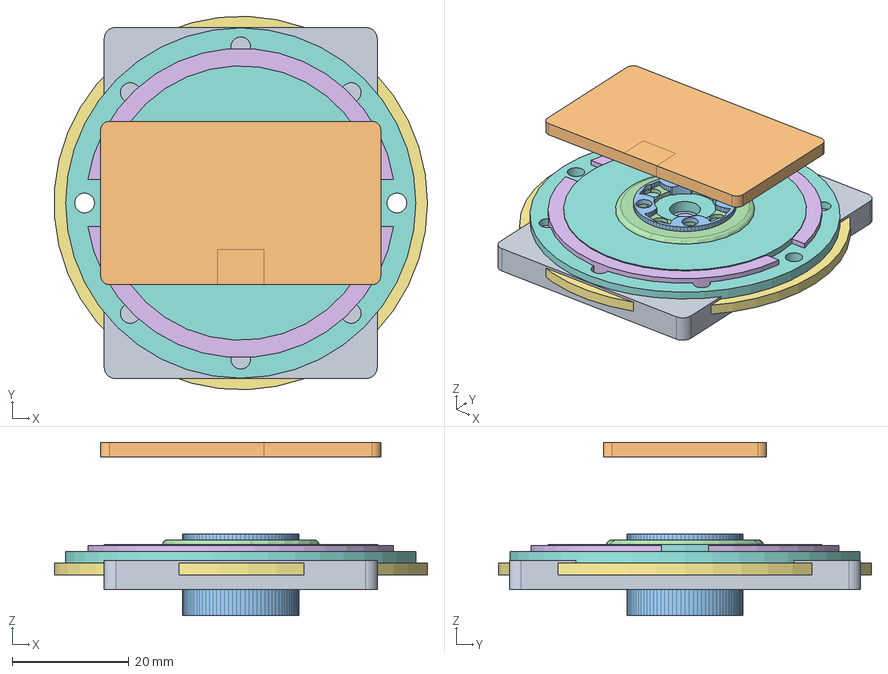
[picture p63: CAD file, 2026-09-26]
机械资料/03_适配模型/02_STEP装配与零件/轮足机器人_HA8_QD4310_全适配总装_v1.step
63.9 x 64.0 x 29.7 mm
