Lianglanquan/--2026/(list of files, cad)

Other CAD files:
机械资料/03_适配模型/03_STL打印件/HA8_舵机接口4_v1.stl
机械资料/03_适配模型/03_STL打印件/HA8_舵机接口1_v1.stl
全部打印STL/02_HA8适配_20件/HA8_被动支撑1_v1.stl
机械资料/03_适配模型/03_STL打印件/HA8_盖板4_v1.stl
全部打印STL/02_HA8适配_20件/HA8_隔套1_v1.stl
机械资料/03_适配模型/02_STEP装配与零件/HA8_盖板3_v1.step
机械资料/03_适配模型/03_STL打印件/HA8_隔套2_v1.stl
全部打印STL/02_HA8适配_20件/HA8_舵机接口3_v1.stl
机械资料/03_适配模型/02_STEP装配与零件/HA8_舵机接口4_v1.step
机械资料/03_适配模型/03_STL打印件/HA8_隔套3_v1.stl
机械资料/03_适配模型/02_STEP装配与零件/HA8_盖板1_v1.step
机械资料/03_适配模型/03_STL打印件/HA8_盖板2_v1.stl
全部打印STL/02_HA8适配_20件/HA8_盖板4_v1.stl
机械资料/03_适配模型/02_STEP装配与零件/HA8_被动支撑3_v1.step
全部打印STL/02_HA8适配_20件/HA8_被动支撑3_v1.stl
机械资料/03_适配模型/02_STEP装配与零件/HA8_舵机接口3_v1.step
全部打印STL/02_HA8适配_20件/HA8_外固定1_v1.stl
机械资料/03_适配模型/02_STEP装配与零件/QD4310_电机固定X1_v1.step
机械资料/03_适配模型/03_STL打印件/HA8_舵机接口2_v1.stl
机械资料/03_适配模型/02_STEP装配与零件/HA8_外固定3_v1.step
全部打印STL/02_HA8适配_20件/HA8_盖板2_v1.stl
机械资料/03_适配模型/02_STEP装配与零件/HA8_被动支撑4_v1.step
全部打印STL/02_HA8适配_20件/HA8_外固定3_v1.stl
机械资料/03_适配模型/02_STEP装配与零件/HA8_外固定1_v1.step
全部打印STL/02_HA8适配_20件/HA8_隔套4_v1.stl
机械资料/03_适配模型/02_STEP装配与零件/HA8_被动支撑1_v1.step
机械资料/03_适配模型/03_STL打印件/HA8_外固定1_v1.stl
全部打印STL/02_HA8适配_20件/HA8_舵机接口4_v1.stl
机械资料/03_适配模型/02_STEP装配与零件/QD4310_轮固定X2_v1.step
机械资料/03_适配模型/02_STEP装配与零件/QD4310_电机固定X2_v1.step
机械资料/03_适配模型/02_STEP装配与零件/HA8_隔套2_v1.step
全部打印STL/02_HA8适配_20件/HA8_隔套3_v1.stl
机械资料/03_适配模型/02_STEP装配与零件/HA8_盖板4_v1.step
机械资料/03_适配模型/03_STL打印件/HA8_隔套1_v1.stl
全部打印STL/02_HA8适配_20件/HA8_隔套2_v1.stl
机械资料/03_适配模型/02_STEP装配与零件/QD4310_轮固定X1_v1.step
机械资料/03_适配模型/03_STL打印件/HA8_被动支撑3_v1.stl
全部打印STL/02_HA8适配_20件/HA8_舵机接口1_v1.stl
机械资料/03_适配模型/02_STEP装配与零件/HA8_舵机接口2_v1.step
全部打印STL/02_HA8适配_20件/HA8_舵机接口2_v1.stl
机械资料/03_适配模型/02_STEP装配与零件/QD4310_轮毂X1_v1.step
机械资料/03_适配模型/03_STL打印件/HA8_舵机接口3_v1.stl
机械资料/03_适配模型/02_STEP装配与零件/HA8_隔套1_v1.step
机械资料/03_适配模型/02_STEP装配与零件/QD4310_轮毂X2_v1.step
机械资料/03_适配模型/03_STL打印件/HA8_被动支撑1_v1.stl
机械资料/03_适配模型/02_STEP装配与零件/HA8_隔套4_v1.step
机械资料/03_适配模型/03_STL打印件/HA8_隔套4_v1.stl
机械资料/03_适配模型/02_STEP装配与零件/HA8_外固定4_v1.step
机械资料/03_适配模型/02_STEP装配与零件/HA8_盖板2_v1.step
机械资料/03_适配模型/02_STEP装配与零件/HA8_外固定2_v1.step
机械资料/03_适配模型/02_STEP装配与零件/HA8_被动支撑2_v1.step
机械资料/03_适配模型/03_STL打印件/HA8_外固定3_v1.stl
机械资料/05_FreeCAD设计/灯哥轮腿改造/灯哥轮腿改造_单腿接口对照_v1.FCStd
机械资料/05_FreeCAD设计/轮足机器人_HA8_QD4310_概念总装_v1.FCStd
