Lianglanquan/--2026/ros2/wheelbot_ws/src/wheelbot_mapping/config/mapper_params_online_sync.yaml

slam_toolbox:
  ros__parameters:
    mode: mapping
    debug_logging: false
    throttle_scans: 1
    transform_publish_period: 0.02
    map_update_interval: 5.0
    resolution: 0.05
    max_laser_range: 8.0
    minimum_time_interval: 0.5
    transform_timeout: 0.2
    tf_buffer_duration: 30.0
    enable_interactive_mode: true
    use_scan_matching: true
    use_scan_barycenter: true
    minimum_travel_distance: 0.10
    minimum_travel_heading: 0.10
    scan_buffer_size: 10
    scan_buffer_maximum_scan_distance: 8.0
    link_match_minimum_response_fine: 0.1
    link_scan_maximum_distance: 1.5
    do_loop_closing: true
    loop_search_maximum_distance: 3.0
    loop_match_minimum_chain_size: 10
    loop_match_maximum_variance_coarse: 3.0
    loop_match_minimum_response_coarse: 0.35
    loop_match_minimum_response_fine: 0.45
    correlation_search_space_dimension: 0.5
    correlation_search_space_resolution: 0.01
    correlation_search_space_smear_deviation: 0.1
    loop_search_space_dimension: 8.0
    loop_search_space_resolution: 0.05
    loop_search_space_smear_deviation: 0.03
    distance_variance_penalty: 0.5
    angle_variance_penalty: 1.0
    fine_search_angle_offset: 0.00349
    coarse_search_angle_offset: 0.349
    coarse_angle_resolution: 0.0349
    minimum_angle_penalty: 0.9
    minimum_distance_penalty: 0.5
    use_response_expansion: true
    map_frame: map
    odom_frame: odom
    base_frame: base_link
    scan_topic: /scan
