Lianglanquan/--2026/(commit log)

2026-09-06 chore: initialize wheelbot project structure
2026-09-16 docs: design xiaozhi wheelbot integration
2026-09-16 docs: plan xiaozhi wheelbot integration
2026-09-16 build: select ESP-IDF 6.1 for ESP32-S3
2026-09-16 vendor: import pinned xiaozhi esp32 baseline
    [16m.csv, 16m_c3.csv, 16m_custom_wakeword.csv, 16m_echoear.csv, 32m.csv, 4m.csv, 4m_esp-hi.csv, 8m.csv]
2026-09-16 feat: integrate wheelbot control safety component
2026-09-16 feat: add wheelbot s3 audio board
2026-09-16 build: add xiaozhi wheelbot firmware workflow
2026-09-16 fix: skip lvgl assets on headless wheelbot board
2026-09-22 chore: sync complete wheelbot project
    [BOM.csv, HA8_关节适配分总成_v1.step, HA8_外固定1_v1.step, HA8_外固定1_v1.stl, HA8_外固定2_v1.step, HA8_外固定2_v1.stl, HA8_外固定3_v1.3mf, HA8_外固定3_v1.step]
2026-09-22 test: add phase1 lidar watchdog coverage
2026-09-22 feat: add lidar scan watchdog node
2026-09-26 chore: checkpoint current wheelbot project
    [ha8_servo_mapping.json, wheelbot_nominal.xml, 灯哥StackForce原始结构_只读参考.FCStd, 灯哥轮腿改造_单腿接口对照_v1.FCStd, 灯哥轮腿改造_单腿接口对照_v2.FCStd, 轮足机器人_HA8_QD4310_概念总装_v1.FCStd, 轮足机器人_HA8_QD4310_概念总装_v2.FCStd, 轮足机器人_左前单腿机械分总成_v1.FCStd]
2026-09-26 feat: implement C board command path and ROS bridge bringup
    [robot_kinematics.yaml]
2026-09-26 Expand QD4310 protocol support and configurable motor count
2026-09-26 feat: integrate XiaoZhi mission orchestration
    [16m.csv, 16m_c3.csv, 16m_custom_wakeword.csv, 16m_echoear.csv, 32m.csv, 4m.csv, 4m_esp-hi.csv, 8m.csv]
2026-09-26 ci: verify complete software mission flow
2026-09-26 feat: add SSD1315 OLED UI for XiaoZhi wheelbot
2026-09-26 feat: expose WheelBot mission tools on XiaoZhi board
